RITMechArch/MechArch/pcbs/HBridge/design/HBridge.jpg

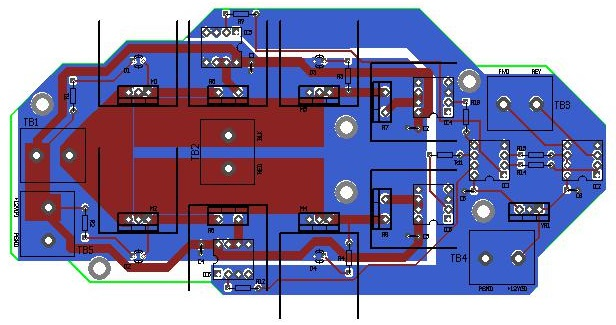
pcbs/HBridge/design/HBridge.jpg
