RITMechArch/MechArch/doc/States & Transitions.jpg

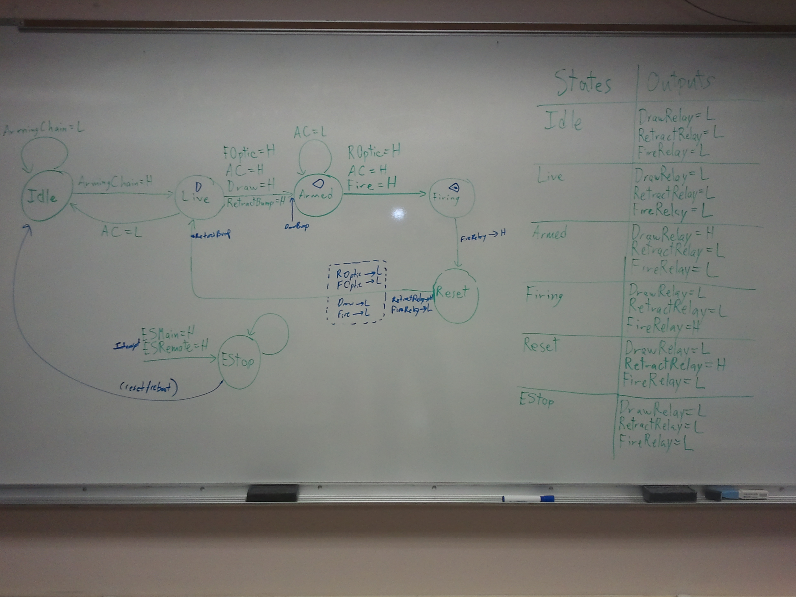
doc/States & Transitions.jpg
