RITMechArch/MechArch/README.md

MechArcher
==========

Mechanical Archer project from the Archery Club at RIT.
