RITMechArch/MechArch/pcbs/HBridge/design/gerber/readme

Reserved for Gerber (RS-274X) PCB files.
