RITMechArch/MechArch/pcbs/Boost Converter/Design/Boost Converter (PCB - PLOT REPORT).txt

PLOT REPORT
-----------

Report File    : C:\Users\Alex\Documents\GitHub\MechArch\pcbs\Boost Converter\Design\Boost Converter (PCB - PLOT REPORT).txt
Report Written : Sunday, February 23, 2014
Design Path    : C:\Users\Alex\Documents\GitHub\MechArch\pcbs\Boost Converter\Design\Boost Converter.pcb
Design Title   : 
Created        : 2/16/2014 10:12:48 AM
Last Saved     : 2/23/2014 3:22:08 PM
Editing Time   : 266 min
Units          : thou (precision 0)

Device Settings
===============

Gerber Settings
===============

    Leading zero suppression.
    G01 assumed throughout.
    Line termination <*> <CR> <LF>.
    2.3 format absolute inches.

    Format commands defined in Gerber file.
    Aperture table defined in Gerber file.
    Hardware arcs allowed.

Drill Settings
==============

    Excellon Format 1    Format 2.3 absolute in mm.
    No zero suppression.

Plots Output
============

    Plot Job: "C:\Users\Alex\Documents\GitHub\MechArch\pcbs\Boost Converter\Design\Boost Converter.mop"

Gerber Output
=============

C:\Users\Alex\Documents\GitHub\MechArch\pcbs\Boost Converter\Design\Boost Converter - Top Silkscreen.gbr

    Layers:
    ----------------
    Top Silkscreen

    D-Code  Shape  (thou)
    ---------------------
    D10     Round 5.00
    D27     Round 7.00

Gerber Output
=============

C:\Users\Alex\Documents\GitHub\MechArch\pcbs\Boost Converter\Design\Boost Converter - Top Copper.gbr

    Layers:
    ------------
    Top Copper

    D-Code  Shape  (thou)
    ---------------------
    D11     Round 150.00
    D12     Round 80.00
    D13     Round 70.00
    D14     Round 60.00
    D15     Round 110.00
    D16     Round 75.00
    D17     Round 15.00
    D18     Round 100.00
    D22     Round 70.00
    D23     Round 90.00

Gerber Output
=============

C:\Users\Alex\Documents\GitHub\MechArch\pcbs\Boost Converter\Design\Boost Converter - Top Copper (Resist).gbr

    Layers:
    ------------
    Top Copper

    D-Code  Shape  (thou)
    ---------------------
    D19     Round 160.00
    D70     Round 90.00
    D71     Round 80.00
    D20     Round 70.00
    D24     Round 120.00
    D25     Round 80.00
    D26     Round 100.00

Gerber Output
=============

C:\Users\Alex\Documents\GitHub\MechArch\pcbs\Boost Converter\Design\Boost Converter - Bottom Copper.gbr

    Layers:
    ---------------
    Bottom Copper

    D-Code  Shape  (thou)
    ---------------------
    D11     Round 150.00
    D12     Round 80.00
    D13     Round 70.00
    D14     Round 60.00
    D15     Round 110.00
    D17     Round 15.00
    D22     Round 70.00
    D23     Round 90.00

Gerber Output
=============

C:\Users\Alex\Documents\GitHub\MechArch\pcbs\Boost Converter\Design\Boost Converter - Bottom Copper (Resist).gbr

    Layers:
    ---------------
    Bottom Copper

    D-Code  Shape  (thou)
    ---------------------
    D19     Round 160.00
    D70     Round 90.00
    D71     Round 80.00
    D20     Round 70.00
    D24     Round 120.00
    D25     Round 80.00
    D26     Round 100.00

NC Drill Output
===============

C:\Users\Alex\Documents\GitHub\MechArch\pcbs\Boost Converter\Design\Boost Converter - Drill Data - Through Hole.drl

    Output:
    --------------------------
    Plated Round Drill Holes
    Plated Slots
    Plated Board Outlines

    Tool   Size       Count    ID
    -----------------------------
    T001   00.030 in  2      K
    T002   00.032 in  12     G
    T003   00.034 in  2      J
    T004   00.040 in  16     D
    T005   00.042 in  5      F
    T006   00.050 in  3      L
    T007   00.057 in  4      H
    T008   00.074 in  2      I
    T009   00.120 in  6      M
    -----------------------------
    Total             52
    -----------------------------
    Tool   Size       Count    ID
    -----------------------------
    T001   00.025 in  1
    -----------------------------
    Total             1
    -----------------------------

Gerber Output
=============

C:\Users\Alex\Documents\GitHub\MechArch\pcbs\Boost Converter\Design\Boost Converter - Drill Ident Drawing - Through Hole.gbr

    Layers:
    ----------------
    [Through Hole]

Drill Ident Drawing
===================

    Drill  Plated  Size  Shape  ID
    ------------------------------
    40     Y       100   Round  D
    42     Y       100   Round  F
    32     Y       100   Round  G
    57     Y       100   Round  H
    74     Y       100   Round  I
    34     Y       100   Round  J
    30     Y       100   Round  K
    50     Y       100   Round  L
    120    Y       100   Round  M

    D-Code  Shape  (thou)
    ---------------------
    D10     Round 5.00
    D18     Round 100.00

Gerber Output
=============

C:\Users\Alex\Documents\GitHub\MechArch\pcbs\Boost Converter\Design\Boost Converter - Board Outline.gbr

    Layers:
    ----------------
    Board Outlines

    D-Code  Shape  (thou)
    ---------------------
    D10     Round 5.00

End Of Report.
