RITMechArch/MechArch/doc/Mechanical Archer Requirements.docx

# Mechanical Archer

Requirements

1 Revision History

2 Background

3 Scope

3.1 In scope

3.2 Out of Scope

4 Functional Requirements

5 Non-Functional Requirements

6 Constraints

7 Assumptions

# 1 Revision History

Revision | Description | Date
0.1 | Created Document | 22APR2012

# 2 Background

The Mechanical Archer project is an effort to engineer and construct a device which will mechanically fire a bow and arrow at a designated target.

# 3 Scope

## 3.1 In scope

1. Control Box
  a. Box design
  b. Wiring
  c. Construction
2. Frame
  a. Design
  b. Construction
3. Firing mechanism
  a. Bow
  b. Drawing mechanism
  c. Release/trigger

## 3.2 Out of Scope

1. “Hands-off” reloading
2. Aiming (beyond pointing the frame itself)

# 4 Functional Requirements

1. System must mechanically fire bow
  a. Manually load arrow
  b. Mechanically pull bowstring to rear
  c. Mechanically release bowstring
  d. Mechanically return mechanism & re-attach to bowstring
2. System must be safely and remotely controlled
  a. Control box
  b. “Dead man’s” switch
  c. Locking/arming key
  d. Sensor to disable drawing/firing when unloaded
3. Riser Attachment System
  a. Cast dragon skin silicone “glove”
  b. Anti-torque structure

# 5 Non-Functional Requirements

1. Bow limb shall be safe and have useful life
  a. Mounting considerations
  b. Winch movement safeguards
2. Frame shall be reliable within tolerances
3. Frame shall be roughly aimable

# 6 Constraints

1. Project budget is $1000
2. Functional & tested by May 2013

# 7 Assumptions

1. Bow draw strength of 50 lbs
2. Available 120V AC outlet
