RITMechArch/MechArch/doc/Projects Slide.pptx

## Mech ArcherThis ain't your daddy's bow

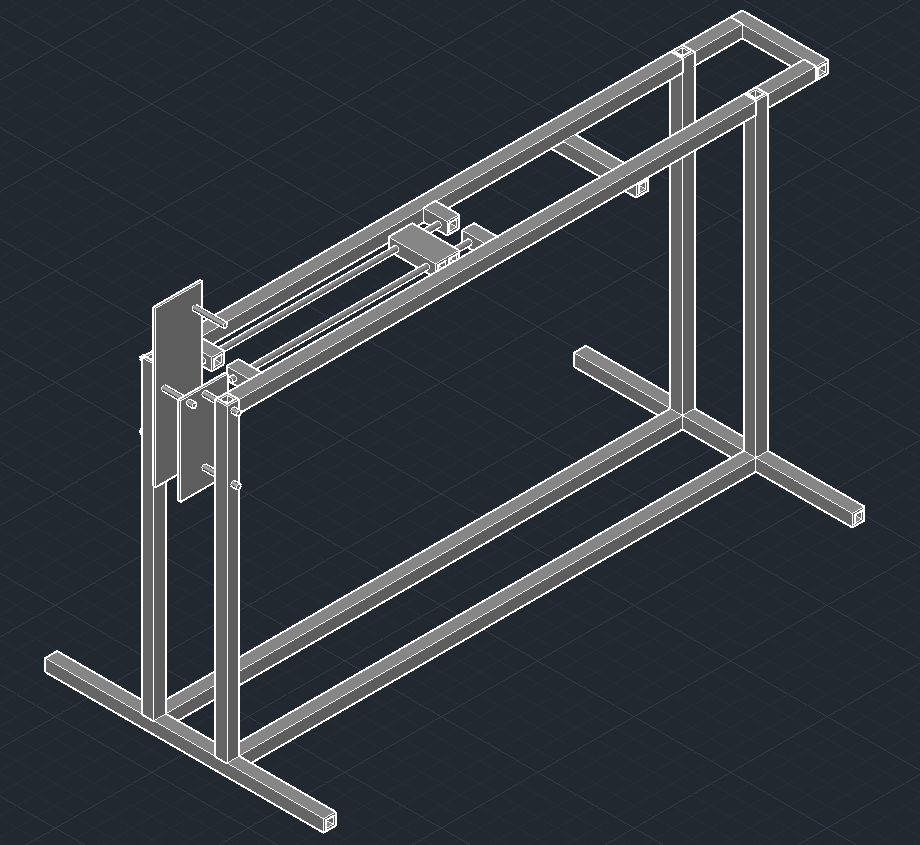
[picture p3: figure]

(insert another picture)
- Imagine RIT exhibit
- Arduino driven
Contact bmb8610@rit.edu for more info

Notes: Style left blank since you're adding this to another presentation
