RITMechArch/MechArch/mechanical/Gear_Motor_Mount_Holes.xlsx

Castor Mount Holes |  | Initial Wheel Holes |  | Rotate: | -14 | degrees | Rotation Result |  | Wheel Mount Holes
D = 3/16" |  |  |  |  | -0.2443460953 | radians |  |  | D = 0.14"
X (in) | Y (in) | X (in) | Y (in) | X (in) | Y (in) |  | X (in) | Y (in) | X (in) | Y (in)
0.5 | 0.5 | 0 | 0 | 0.9702957263 | 0.2419218956 |  | 0 | 0 | 1 | 1.75
2.875 | 0.5 | 1.061 | 0 | -0.2419218956 | 0.9702957263 |  | 1.029 | -0.257 | 2.029483766 | 1.493320869
0.5 | 4.125 | 0 | 1.5 |  |  |  | 0.363 | 1.455 | 1.362882843 | 3.205443589
2.875 | 4.125 | 1.061 | 1.5 |  |  |  | 1.392 | 1.199 | 2.392366609 | 2.948764458
Initial Motor Holes |  |  |  |  |  |  |  |  | Motor Mount Holes
 |  |  |  |  |  |  |  |  | D = 0.14"
X (in) | Y (in) | X (in) | Y (in) |  |  |  |  |  | X (in) | Y (in)
-1.0945 | 0 | -1.0945 | 4 |  |  |  | -0.09430109001 | 4.14596642 | 0.90569891 | 5.89596642
2.1555 | 0 | 2.1555 | 4 |  |  |  | 3.059 | 3.360 | 4.05916002 | 5.109720259
-1.0945 | 2.125 | -1.0945 | 6.125 |  |  |  | 0.420 | 6.208 | 1.419782938 | 7.957844838
2.1555 | 2.125 | 2.1555 | 6.125 |  |  |  | 3.573 | 5.422 | 4.573244049 | 7.171598677
On Mill Positions:
Castor Mount Holes |  | Wheel Mount Holes |  | Motor Mount Holes
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
