RITMechArch/MechArch/doc/Pinout-R2.xlsx

Sheet: Frameside
Signal Name | Signal Type | In/Out | Pin # | PWM | Interrupt-Driven | Description
E-StopRemote | Digital | Input | 18 | No | Yes(5) | Emergency Stop button on frame
E-StopMain | Digital | Input | 19 | No | Yes(4) | Emergency Stop button on control box
FOptic | Digital | Input | 30 | No | No | Front optical sensor (low: arrow present; high: arrow absent)
ROptic | Digital | Input | 32 | No | No | Rear optical sensor (low: arrow present; high: arrow absent)
Drawing Linac Feedback Pin | Analog | Input | A2 | No | No | Feedback pin for the drawing linear actuator.
Drawing Linac Motor Enable | Digital | Output | 3 | Yes | No | Enable for the drawing linear actuator.
Drawing Linac Motor Direction | Digital | Output | 5 | No | No | Direction for the drawing linear actuator.
Aiming Linac Feedback Pin | Analog | Input | A5 | No | No | Feedback pin for the aiming linear actuator.
Aiming Linac Motor Enable | Digital | Output | 6 | Yes | No | Enable for the aiming linear actuator.
Aiming Linac Motor Direction | Digital | Output | 8 | No | No | Direction for the aiming linear actuator.
Aiming Gear Motor Enable | Digital | Output | 9 | Yes | No | Enable for the aiming gear motor.
Aiming Gear Motor Direction | Digital | Output | 12 | No | No | Direction for the aiming gear motor.
Rotary Encoder PinA | Digital | Input | 21 | No | Yes(3) | Interrupt Pin A on the rotary encoder.
Rotary Encoder PinB | Digital | Input | 20 | No | Yes(2) | Interrupt Pin B on the rotary encoder.
High Power Solenoid | Digital | Output | 38 | No | No | High power fire solenoid used for firing.
Low Power Solenoid | Digital | Output | 40 | No | No | Low power fire solenoid used to grab the string.
Ethernet Shield SD Select | Digital | Output | 4 | No | No | SD Card Select on the Ethernet shield; this must be disabled.
Ethernet Shield W5100 Select | Digital | Output | 10 | No | No | Wired Ethernet select on the Ethernet shield.
Ethernet Shield SPI Output | Digital | Output | 53 | No | No | Required output for the Ethernet shield, per Arduino Ethernet Shield main page.

Sheet: Control Box
Signal Name | Signal Type | In/Out | Pin # | PWM | Interrupt-Driven | Description
RX0 | Digital | Input | 0 | No | No | Receiving line for serial communications
TX0 | Digital | Output | 1 | No | No | Transmitting line for serial communications
E-StopRemote | Digital | Input | 18 | No | Yes(5) | Emergency stop button on the frame
E-StopMain | Digital | Input | 19 | No | Yes(4) | Emergency stop button on the control box
LEDClock | Digital | Output | 30 | No | No | Time until next fire information
LEDData | Digital | Output | 32 | No | No | Data output for LED shift registers.
LCDRegSelect | Digital | Output | 37 | No | No | Register Select for LCD display on control box
LCDEnable | Digital | Output | 39 | No | No | Enable for LCD display on control box
Arming Chain | Digital | Input | 40 | No | No | Combination of key, switch, and deadman button on the control box.
DrawInput | Digital | Input | 42 | No | No | Draw button on the control box
RetractInput | Digital | Input | 44 | No | No | Retract button on the control box
FireInput | Digital | Input | 46 | No | No | Fire button on the control box
LCD Data, D4/D5/D6/D7 | Digital | Output | 41/43/45/47 | No | No | Data pins for LCD display on control box.
