RITMechArch/MechArch/pcbs/HBridge/ATTiny13A_Pinout.xls

ATTiny13A Pinout
Physical Pin | Pin Label | Description
1 | PB5 | PMOS M1
2 | PB3 | Forward signal
3 | PB4 | Reverse signal
4 | GND | Ground
5 | PB0 | NMOS M3 (PWM)
6 | PB1 | NMOS M4 (PWM)
7 | PB2 | PMOS M2
8 | VCC | 5V rail
