RITMechArch/MechArch/doc/State Diagram - R2.jpg

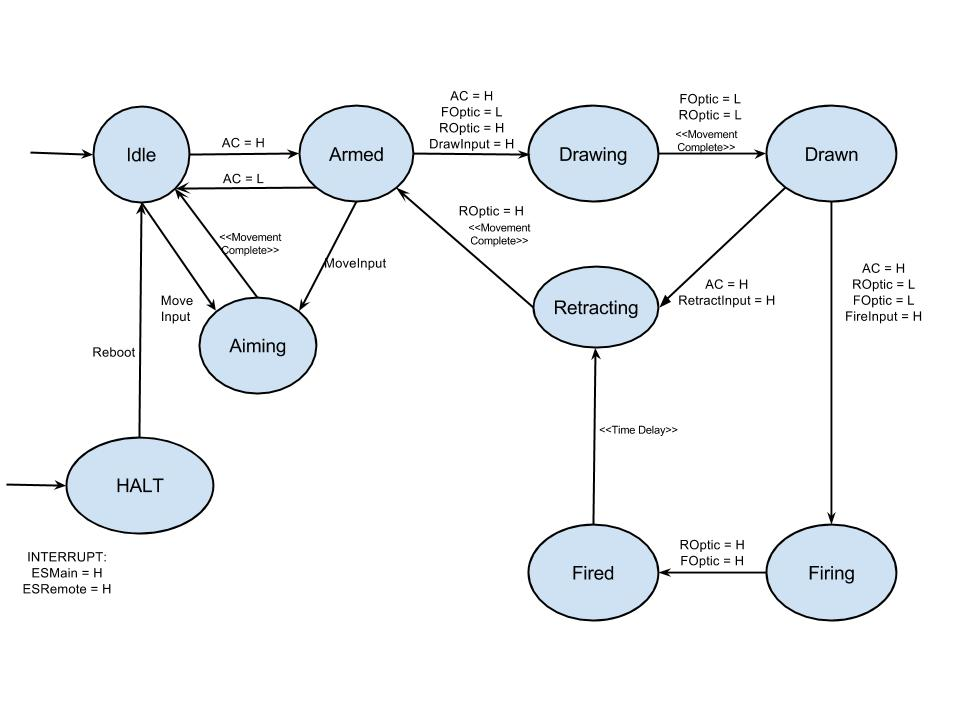
doc/State Diagram - R2.jpg
