RITMechArch/MechArch/mechanical/Design Spark Parts/Mechanical Archer Frame.png

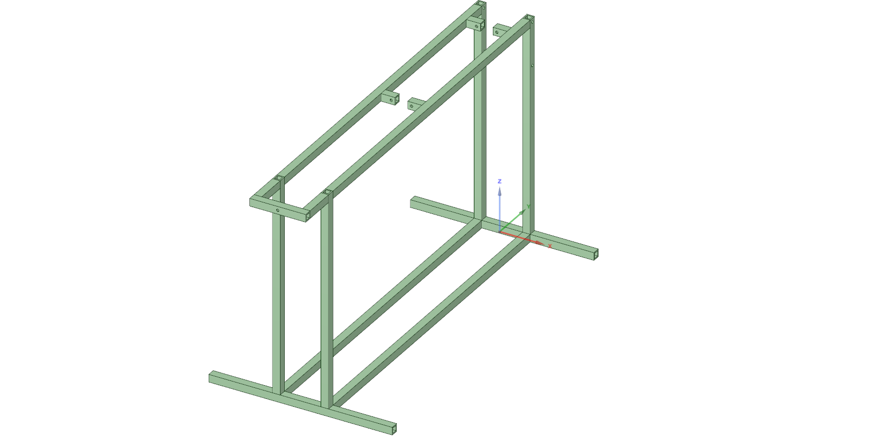
mechanical/Design Spark Parts/Mechanical Archer Frame.png
