RITMechArch/MechArch/pcbs/Boost Converter/Design/Boost Converter PCB.png

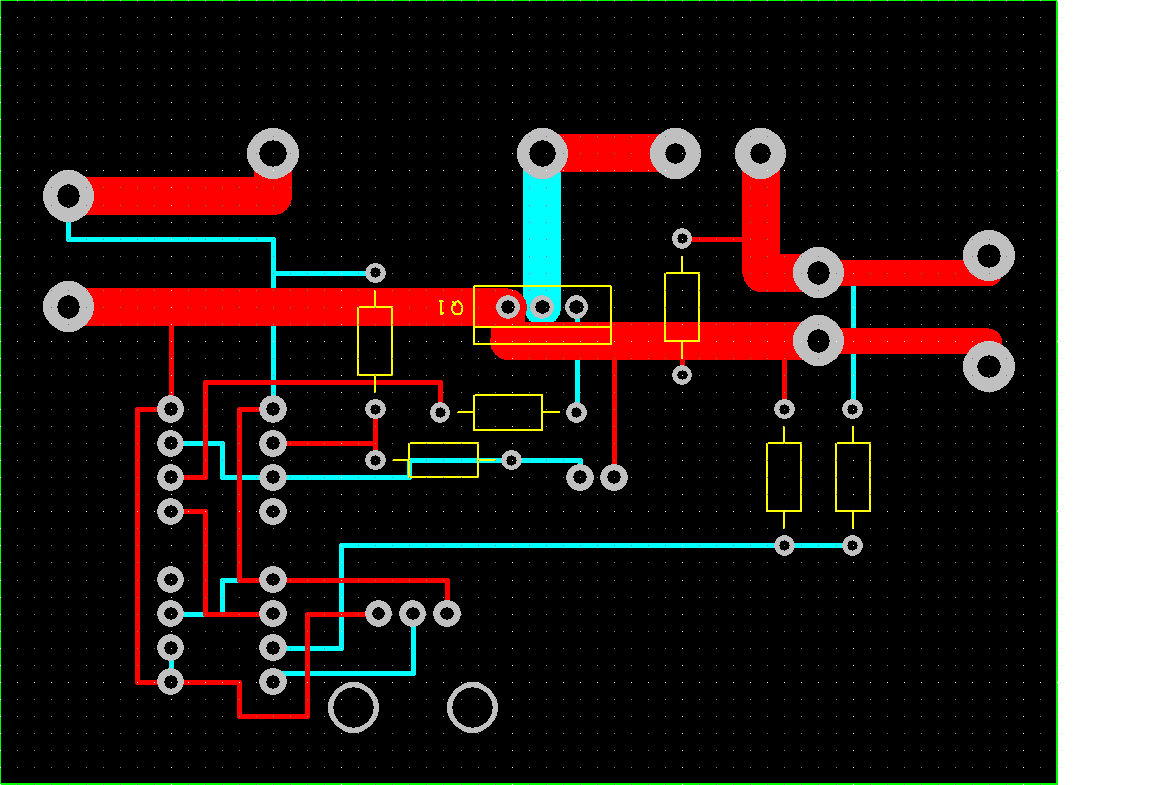
pcbs/Boost Converter/Design/Boost Converter PCB.png
