RITMechArch/MechArch/pcbs/Boost Converter/Design/Boost Converter.png

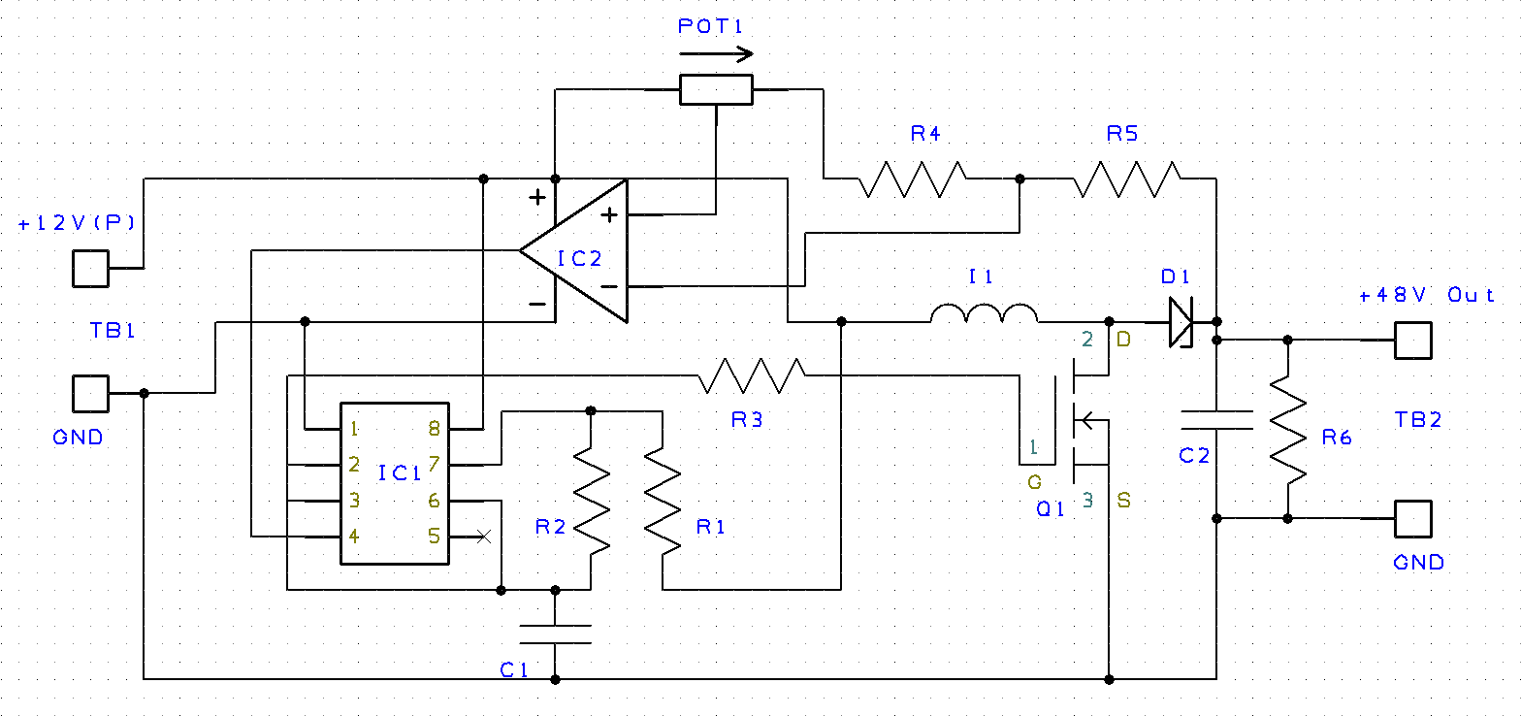
pcbs/Boost Converter/Design/Boost Converter.png
