RITMechArch/MechArch/pcbs/solenoid/design/solenoid.jpeg

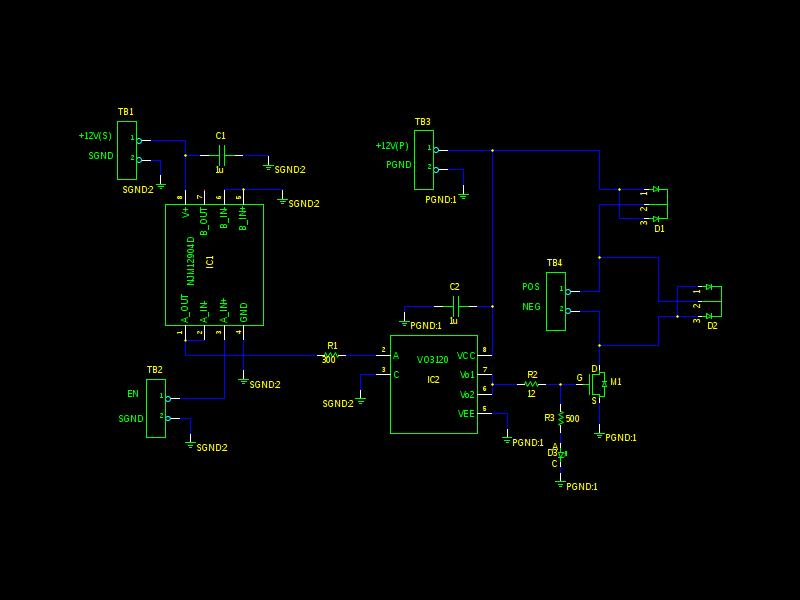
pcbs/solenoid/design/solenoid.jpeg
