RITMechArch/MechArch/pcbs/solenoid/design/solenoid.jpg

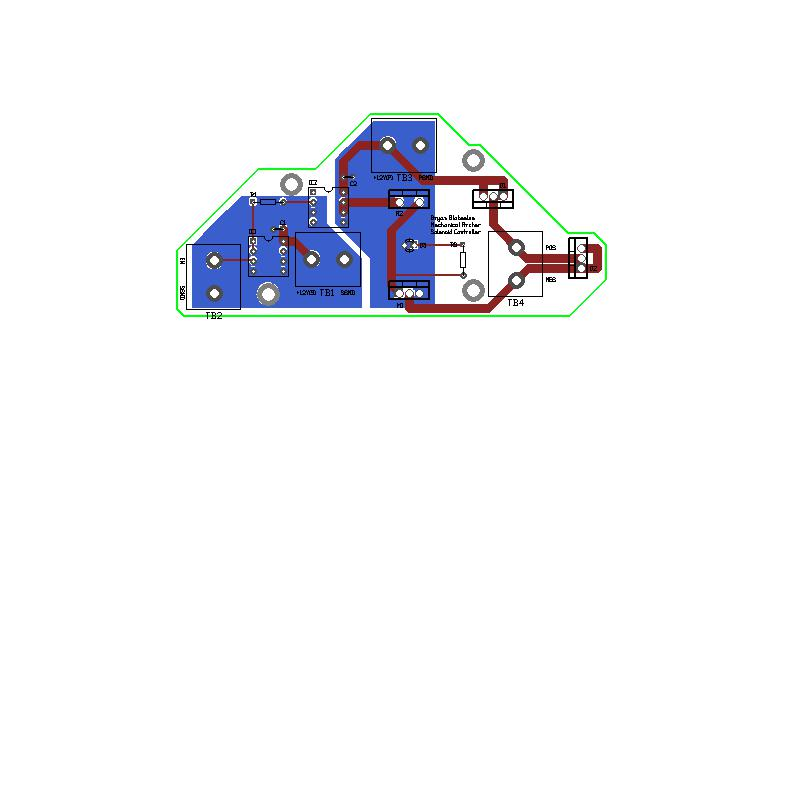
pcbs/solenoid/design/solenoid.jpg
