RITMechArch/MechArch/doc/Control_BOM.xlsx

Part # | Distributor | Description | Quantity | Unit Price | Total Price
V2018-ND | DigiKey | Solder proto board, common bus strips | 1 | 5.75 | 5.75
94669A097 | McMaster | Mounting spacer, M3, 4mm length | 12 | 0.29 | 3.48
96741A122 | McMaster | Machine screw, M3, 12mm length, 50 pk. | 1 | 7.11 | 7.11
94150A325 | McMaster | Nut for machine screw, M3, 50 pk. | 1 | 3.08 | 3.08
93925A240 | McMaster | Locking washers, M3, 100 pk. | 1 | 2.26 | 2.26
CKM12BTW01 | Mouser | Key switch | 1 | 11.66 | 11.66
M2012SS1G01-RO | Mouser | Master arm toggle switch | 1 | 4.76 | 4.76
MB2011SD3G01-CA | Mouser | Pushbutton switch, Draw, Black | 4 | 5.85 | 23.40
AT407F | Mouser | Cap, pushbutton switch, Retract, Green | 1 | 1.13 | 1.13
AT407C | Mouser | Cap, pushbutton switch, Fire, Red | 1 | 0.59 | 0.59
AT407B | Mouser | Cap, pushbutton switch, Deadman, White | 1 | 0.53 | 0.53
KB16CKG01-CC | Mouser | E-Stop button | 2 | 9.15 | 18.30
P160KNP-0QD20B10K | Mouser | Brightness trimmer pot for screen | 1 | 0.88 | 0.88
JBH-4957-KO | Mouser | Metal electronics enclosure | 1 | 20.50 | 20.50
RN60D2501FB14 | Mouser | Current limiting resistor, 2.5k | 8 | 0.20 | 1.60
SRCN2A25-16S | Mouser | Panel mount connector, female, 16 pin | 2 | 6.71 | 13.42
SRCN6A25-16P | Mouser | Cable connector, male, 16 pin | 2 | 11.59 | 23.18
163-MJ22-EX | Mouser | Panel mount DC barrel jack | 1 | 2.77 | 2.77
412-212103 | Mouser | Wall wart, 12VDC, barrel plug | 2 | 12.19 | 24.38
MC7805CTG | Mouser | Linear regulator, 5VDC, 1A | 2 | 0.40 | 0.80
FDH33_Q | Mouser | Diode for LCD screen backlight | 1 | 0.03 | 0.03
LCD-00256 | SparkFun | Monochrome 4x20 screen | 1 | 17.95 | 17.95
PRT-00116 | SparkFun | Header strip, 40 pin, vertical | 1 | 1.50 | 1.50
PRT-09140 | SparkFun | Jumper wires, M/F, 6", 10 pk. | 2 | 3.95 | 7.90
PRT-09385 | SparkFun | Jumper wires, M/F, 12", 10 pk. | 1 | 4.50 | 4.50
COM-10002 | SparkFun | Potentiometer knob | 1 | 1.50 | 1.50
 |  |  |  | Total Cost | 202.96
