RITMechArch/MechArch/pcbs/Boost Converter/Boost Converter BOM.xlsx

Part Number | Description | Price | Quantity | Cost | Reference Designator
512-LM555CN | 555 Timer IC for boost converter PWM | $0.44 | 1 | $0.44 | IC1
581-SR151A101JAR | Timing Capacitor for 555 Timer, 100 pF | $0.23 | 1 | $0.23 | C1
71-RN65C8002B | R1 timing resistor for 555 Timer, 80 KOhm | $1.06 | 1 | $1.06 | R1
71-PTF5640K000BYEB | R2 timing resistor for 555 Timer, 40 KOhm | $0.61 | 1 | $0.61 | R2
71-CMF6080R000BHEB | Output current limiting resistor for 555 Timer, 80 Ohm | $0.46 | 1 | $0.46 | R3
542-1130-220K-RC | Inductor for Boost Convertor, 22 uH | $4.64 | 1 | $4.64 | I1
863-MBR1060G | Boost Converter flyback diode | $0.99 | 1 | $0.99 | D1
844-IRFIZ14GPB | Boost Converter switching transistor, N-MOS | $1.65 | 1 | $1.65 | Q1
647-UVY2G100MPD | Boost Converter output leveling capacitor, 10 uF | $0.62 | 1 | $0.62 | C2
594-VR37000001004FR5 | Feedback voltage divider low side resistor, 1 MOhm | $0.19 | 1 | $0.19 | R4
71-CMF5519M100GNBF | Feedback voltage divider high side resistor, 19.1 MOhm | $0.52 | 1 | $0.52 | R5
595-RC4558P | Feedback op-amp for controlling RESET on 555 | $0.43 | 1 | $0.43 | IC2
688-RK09K1130AP5 | Feedback reference voltage potentiometer, 10 KOhm | $0.49 | 1 | $0.49 | POT1
791-RC1/2-203JB | Bleeder resitor for leveling capacitor, 20 KOhm | $0.36 | 1 | $0.36 | R6
571-1977477-2 | Terminal blocks for input and output | $1.45 | 2 | $2.90 | TB1, TB2
517-4808-3000-CP | Socket for 8-pin ICs | $0.28 | 2 | $0.56
 |  |  | Board: | $33.00
 |  |  | Parts: | $16.15
 |  |  | Total: | $49.15
