RITMechArch/MechArch/Things to buy as of 2-19-2014.xlsx

Mouser.com Part Number | Description | Price | Quantity | Cost | Reference Designator
828-OP906 | IR laser detector photodiode | $0.55 | 2 | $1.10 | PD1
MFS1/4DCT52R2003F | Photodiode current limiter, 200 kOhms | $0.06 | 2 | $0.12 | R1
T73YU103KT20 | Reference potentiometer, 10 kOhms | $0.71 | 2 | $1.42 | R2
513-NJM12904D | Op-amp comparator | $0.49 | 2 | $0.98 | U1
571-1977477-2 | Terminal block, 2 position | $1.37 | 8 | $10.96 | TB1, TB2
859-LTL-1CHAE | Activity indicator LED | $0.08 | 2 | $0.16 | D2
660-MF1/4DCT52R2000F | LED current limiter, 200 Ohms | $0.06 | 4 | $0.24 | R3
810-FK14X7R1H105K | Bypass cap for op-amps, 1 uF | $0.40 | 2 | $0.80 | C1
828-OPV310 | Laser diode | $11.45 | 2 | $22.90 | D1
660-MF1/4DC1501F | Current limiting resistor, 1.5k Ohms | $0.06 | 2 | $0.12 | R1
CMF55500R00FEBF | Current limiting resistor, 500 Ohms | $0.25 | 2 | $0.50 | R2
859-LTL-1CHAE | Activity indicator LED | $0.08 | 2 | $0.16 | D2
512-LM555CN | 555 Timer IC for boost converter PWM | $0.44 | 1 | $0.44 | IC1
581-SR151A101JAR | Timing Capacitor for 555 Timer, 100 pF | $0.23 | 1 | $0.23 | C1
71-RN65C8002B | R1 timing resistor for 555 Timer, 80 KOhm | $1.06 | 1 | $1.06 | R1
71-PTF5640K000BYEB | R2 timing resistor for 555 Timer, 40 KOhm | $0.61 | 1 | $0.61 | R2
71-RS00280R00FE70 | Output current limiting resistor for 555 Timer, 80 Ohm | $0.46 | 1 | $0.46 | R3
542-1130-220K-RC | Inductor for Boost Convertor, 22 uH | $4.64 | 1 | $4.64 | I1
863-MBR1060G | Boost Converter flyback diode | $0.99 | 1 | $0.99 | D1
511-STP16NF06 | Boost Converter switching transistor, N-MOS | $0.88 | 1 | $0.88 | Q1
647-UVY2G100MPD | Boost Converter output leveling capacitor, 10 uF | $0.62 | 1 | $0.62 | C2
660-MF1/4DCT52R9532F | Feedback voltage divider high side resistor, 95.3 kOhm | $0.06 | 1 | $0.06 | R4
71-CMF555K0000BHEB | Feedback voltage divider low side resistor, 5.0 kOhm | $0.59 | 1 | $0.59 | R5
594-VR37000001004FR5 | Output capacitor bleeder resistor, 1 Mohm | $0.19 | 1 | $0.19 | R6
595-RC4558P | Feedback op-amp for controlling RESET on 555 | $0.43 | 1 | $0.43 | IC2
688-RK09K1130AP5 | Feedback reference voltage potentiometer, 10 KOhm | $0.49 | 1 | $0.49 | POT1
517-4808-3000-CP | Socket for 8-pin ICs | $0.28 | 2 | $0.56
852-PC81100NSZ0F | Opto-isolator for H-Bridge interface | $0.28 | 2 | $0.56
602-3055-100-28 | 100 feet 18AWG | $37.03 | 1 | $37.03
602-3051-100-14 | 100 feet 22AWG | $21.92 | 1 | $21.92
Pololu.com Part Number | Description | Price | Quantity | Cost | Reference Designator
755 | H-Bridge power side | $39.95 | 1 | $39.95
1404 | Linear Actuator travel limit switches | $0.85 | 2 | $1.70
 |  |  | Parts Cost: | $152.87
