RITMechArch/MechArch/R_2.5/NetworkingFields.ods

Sheet: Arduino to Computer
Component | Possible Values | Size (Bytes) | Notes
E-Stop Status | 1 (Active), 0 (Inactive) | 1
X Position | -4000 to 4000 | 2 | Exact range yet to be determined, and may be converted to an unsigned value from 0-8000.
Y Position | 100 to 4000 | 2 | Exact range to be determined
Z Position | 100 to 4000 | 2 | Exact range to be determined; lower positions correspond to a drawn bow, higher positions correspond to a retracted bow.
Front Optic Sensor | 1 (Arrow absent), 0 (Arrow present) | 1
Rear Optic Sensor | 1 (Arrow absent), 0 (Arrow present) | 1
Firing Block Status | 1(Open), 0(Closed) | 1 | This value currently assumes the solenoid mechanism used in revision 2. The value may change to use a servo with a valid range of 0-180, still using 1 byte.
String Held | 1(True), 0(False) | 1
Current Sensor 1 | 0-5000? | 2 | Need to verify range
Current Sensor 2 | 0-5000? | 2 | Need to verify range
Current Sensor 3 | 0-5000? | 2 | Need to verify range
Current Sensor 4 | 0-5000? | 2 | Need to verify range

Sheet: Computer to Arduino
Component | Possible Values | Size (Bytes) | Notes
E-Stop Status | 1 (Active), 0 (Inactive) | 1
Draw Input | 1 (Active), 0 (Inactive) | 1 | Mutually exclusive with Retract Input and Fire Input
Retract Input | 1 (Active), 0 (Inactive) | 1 | Mutually exclusive with Draw Input and Fire Input
Fire Input | 1 (Active), 0 (Inactive) | 1 | Mutually exclusive with Draw Input and Retract Input
X Target Position | -4000 to 4000 | 2 | Exact range yet to be determined, and may be converted to an unsigned value from 0-8000.
Y Target Position | 100 to 4000 | 2 | Exact range to be determined
