RITMechArch/MechArch/doc/EEPROM Byte Listing.xlsx

Name | Starting Byte Number | Size (bytes) | Description
GM_MinPower | 0 | 1 | Minimum power for the horizontal aiming gear motor
GM_MaxPower | 4 | 1 | Maximum power for the horizontal aiming gear motor
GM_MinPosition | 8 | 2 | Minimum position the gear motor can move to.
GM_MaxPosition | 12 | 2 | Maximum position the gear motor can move to.
GM_FineControlDist | 16 | 2 | Distance from the current position at which proportional control will be used to slow the gear motor's movement for increased precision.
GM_Overshoot | 20 | 2
GM_MinMovement | 24 | 2 | Minimum position difference needed to trigger a move by the gear motor.
GM_ProportionalConst | 28 | 2 | Constant to be used in proportional controller for movement.
GM_IntegralConst | 32 | 2 | Constant to be used in integral controller for movement.
AL_MinPower | 36 | 1 | Minimum power for the aiming linear actuator.
AL_MaxPower | 40 | 1 | Maximum power for the aiming linear actuator.
AL_ZeroPosition | 44 | 2 | Center position for the aiming linear actuator.
AL_MinPosition | 48 | 2 | Minimum position the aiming linear actuator can move to.
AL_MaxPosition | 52 | 2 | Maximum position the aiming linear actuator can move to.
AL_FineControlDist | 56 | 2 | Distance from the current position at which proportional control will be used to slow the aiming linear actuator movement for increased precision.
AL_Overshoot | 60 | 2
AL_MinMovement | 64 | 2 | Minimum position difference needed to trigger a move by the aiming linear actuator.
AL_ProportionalConst | 68 | 2 | Constant to be used in proportional controller for movement.
AL_IntegralConst | 72 | 2 | Constant to be used in integral controller for movement.
DL_MinPower | 76 | 1 | Minimum power for the drawing linear actuator
DL_MaxPower | 80 | 1 | Maximum power for the drawing linear actuator
DL_MinPosition | 84 | 2 | Minimum position the drawing linear actuator can move to.
DL_MaxPosition | 88 | 2 | Maximum position the drawing linear actator can move to.
DL_IdlePosition | 92 | 2 | Position of the drawing linear actuator when the bow is retracted in an idle state.
DL_StringPosition | 96 | 2 | Position of the drawing linear actuator when grabbing the bow string.
DL_DrawnPosition | 100 | 2 | Position of the drawing linear actuator when the bow is considered drawn.
DL_FineControlDist | 104 | 2 | Distance from the current position at which proportional control will be used to slow the drawing linear actuator's movement for increased precision.
DL_Overshoot | 108 | 2
DL_MinMovement | 112 | 2 | Minimum position difference needed to trigger a move by the drawing linear actuator.
DL_ProportionalConst | 116 | 2 | Constant to be used in proportional controller for movement.
DL_IntegralConst | 120 | 2 | Constant to be used in integral controller for movement.
