RITMechArch/MechArch/doc/Mech Arch R2 Buy List.xlsx

Part # | Description | Price (USD) | Quantity | Total | Source
SDA18-263 | Linear Actuator for Vertical Positioning | $399.99 | 1 | $399.99 | servocity.com
CEM-1210-1M | Gear Motors for Horizontal Positioning | $59.99 | 2 | $119.98 | servocity.com
HDM500 | Linear Actuator Mounting Bracket | $34.99 | 2 | $69.98 | servocity.com
535158 | Pillow Block Bearing for Gear Motors and front hinges | $6.99 | 8 | $55.92 | servocity.com
595410 | 4" diameter heavy duty wheels | $6.99 | 2 | $13.98 | servocity.com
545560 | 0.770" set screw hub | $4.99 | 2 | $9.98 | servocity.com
 |  |  |  | $0.00
AD7706BNZ-ND | 3 Channel 16 bit ADC | $10.76 | 2 | $21.52 | digikey.com
CTX403-ND | 4.9152 MHz crystal oscillator for ADC master clock | $0.36 | 2 | $0.72 | digikey.com
338-1051-ND | 20 pF capacitors for the crystal oscillators | $1.63 | 4 | $6.52 | digikey.com
S110HCT-ND | 110 Ohm resistors for current limiting on the display LEDs | $0.04 | 50 | $2.13 | digikey.com
IRL640A | N-Channel MOSFET; 200V; 18A; for controlling the solenoid | $1.52 | 2 | $3.04 | digikey.com
PS2501-4A-ND | 4 Channel optoisolator | $1.84 | 1 | $1.84 | digikey.com
S240HCT-ND | 240 ohm resistor for optoisosolator output | $0.11 | 5 | $0.55 | digikey.com
CF14JT10K0CT-ND | 10k resistor for optoisolator output | $0.10 | 10 | $1.00 | digikey.com
30QBK-ND | 30 ohm resistor for LED display | $0.04 | 35 | $1.54 | digikey.com
CF14JT20K0CT-ND | 20k pull down resistor for transistor | $0.10 | 5 | $0.50 | digikey.com
 |  |  |  | $0.00
B003ZHV3TW | 1/2” x 5” x 36” 6061 Aluminum bar for gear motor mounts | $55.56 | 2 | $111.12 | amazonsupply.com
 |  |  |  | $0.00
 |  |  |  | $0.00
 |  |  |  | $0.00
 |  |  |  | $0.00
 |  |  |  | $0.00
 |  |  |  | $0.00
 |  |  |  | $0.00
 |  |  | Total: | $820.31
