RITMechArch/MechArch/doc/MechArchBudget.xls

Budget: | SSE Money: | $500.00
 | Archery Money: | $300.00
 | Total Money: | $800.00
 | SSE Money Spent: | $89.99
 | Archery Money Spent: | $311.67
 | SSE Money Remaining: | $410.01
 | Archery Money Remaining: | -$11.67
 | Total Money Remaining: | $398.34
 | Anticipated Expenses: | $211.07
 | Anticipated Total Money Remaining: | $187.27
Archery Expenses |  |  | SSE Expenses |  | Anticipated Expenses
Name | Cost |  | Name | Cost | Name | Cost | Notes
H-Bridge Parts | $94.58 |  | New power supply | $89.99 | Solenoid Controller Parts | $17.12
H-Bridge PCB (Wrong) | $92.75 |  |  |  | Solenoid Controller PCB | $43.95
Archery Release | $30.00 |  |  |  | Misc Wire & Lugs | $100.00 | Estimate
Solenoid | $16.95 |  |  |  | Acrylic & Sheet Metal | $50.00 | Estimate
Sensor Parts | $37.44
Motor Controller | $39.95
