RITMechArch/MechArch/pcbs/IR_Tx/IR_Tx_BoM.xls

Part Number | Description | Price | Quantity | Cost | Reference Designator
828-OPV310 | Laser diode | $11.45 | 2 | $22.90 | D1
660-MF1/4DC1501F | Current limiting resistor, 1.5k Ohms | $0.06 | 2 | $0.12 | R1
571-1977477-2 | Terminal block, 2 position | $1.37 | 2 | $2.74 | TB1
CMF55500R00FEBF | Current limiting resistor, 500 Ohms | $0.25 | 2 | $0.50 | R2
859-LTL-1CHAE | Activity indicator LED | $0.08 | 2 | $0.16 | D2
 |  |  | Board Cost | $8.23
 |  |  | Parts Cost | $26.42
 |  |  | Total Cost | $34.65
