RITMechArch/MechArch/pcbs/HBridge/BoM.xls

Part Number | Description | Price | Quantity | Cost | Reference Designator
726-IPP80P03P4L-04 | High side H-Bridge PMOS transistor | $1.95 | 3 | $5.85 | M1, M2
511-STP16NF06 | Low side H-Bridge NMOS transistor | $0.88 | 3 | $2.64 | M3, M4
504222B00000G | TO-220 heat sinks | $0.56 | 8 | $4.48 | N/A
556-ATTINY13A-PU | Microcontroller for signal decoding | $0.95 | 3 | $2.85 | IC1
513-NJM12904D | Dual op-amp buffers for high impedance input | $0.49 | 3 | $1.47 | IC2
810-FK14X7R1H105K | Bypass capacitors for ICs, 1uF | $0.40 | 6 | $2.40 | C1, C2, C3, C4, C5, C6
595-UA7805CKCT | Linear regulator for powering ATTiny | $0.60 | 2 | $1.20 | VR1
517-4808-3000-CP | Socket for 8-pin ICs | $0.28 | 8 | $2.24 | N/A
571-1977477-2 | Barrier terminal, 2 position | $1.37 | 5 | $6.85 | TB1, TB2, TB3, TB4, TB5
859-LTL-1CHAE | LED activity indicators | $0.08 | 6 | $0.48 | D1, D2, D3, D4
CMF55500R00FEBF | LED resistors, 500 Ohm | $0.25 | 6 | $1.50 | R1, R2, R3, R4
652-PWR221T-30-12R0F | Gate drive limiting resistors, 12 Ohm, 30W | $2.63 | 6 | $15.78 | R5, R6, R7, R8
71-CMF55250R00FKBF | Current limiting resistors for 5V signal lines, 250 Ohm | $0.16 | 6 | $0.96 | R13, R14
660-MF1/4DCT52R3000F | Current limiting resistors for gate driver LEDs, 300 Ohm | $0.06 | 8 | $0.48 | R9, R10, R11, R12
782-VO3120 | Opto-isolator, level shifter, current buffer | $1.55 | 5 | $7.75 | IC3, IC4, IC5, IC6
 |  |  | Board Cost | $85.50 | For 3 copies of the board
 |  |  | Part Cost | $56.93
 |  |  | Total Cost | $142.43
