RITMechArch/MechArch/pcbs/bumpSwitch/bumpSwitch_BoM.xls

Part Number | Description | Price | Quantity | Cost | Reference Designator
653-SS-01GL2 | Limit switch for actuator travel | $3.20 | 2 | $6.40 | N/A
