RITMechArch/MechArch/pcbs/solenoid/Solenoid_BoM.xls

Part Number | Description | Price | Quantity | Cost | Reference Designator
511-STP16NF06 | Solenoid control FET | $0.88 | 1 | $0.88 | M1
504222B00000G | TO-220 heat sinks | $0.56 | 4 | $2.24 | N/A
513-NJM12904D | Dual op-amp buffers for high impedance input | $0.49 | 1 | $0.49 | IC1
810-FK14X7R1H105K | Bypass capacitors for ICs, 1uF | $0.40 | 2 | $0.80 | C1, C2
517-4808-3000-CP | Socket for 8-pin ICs | $0.28 | 2 | $0.56 | N/A
571-1977477-2 | Barrier terminal, 2 position | $1.37 | 4 | $5.48 | TB1, TB2, TB3, TB4
859-LTL-1CHAE | LED activity indicators | $0.08 | 1 | $0.08 | D3
CMF55500R00FEBF | LED resistors, 500 Ohm | $0.25 | 1 | $0.25 | R3
652-PWR221T-30-12R0F | Gate drive limiting resistors, 12 Ohm, 30W | $2.63 | 1 | $2.63 | R2
660-MF1/4DCT52R3000F | Current limiting resistors for gate driver LEDs, 300 Ohm | $0.06 | 1 | $0.06 | R1
782-VO3120 | Opto-isolator, level shifter, current buffer | $1.55 | 1 | $1.55 | IC2
755-RSX1001T3 | Protection diodes for solenoid inductor | $1.05 | 2 | $2.10 | D1, D2
 | Board Cost:
 | Part Cost: | $17.12
 | Total Cost: | $17.12
