RITMechArch/MechArch/mechanical/Design Spark Parts/Firing Block Back.png

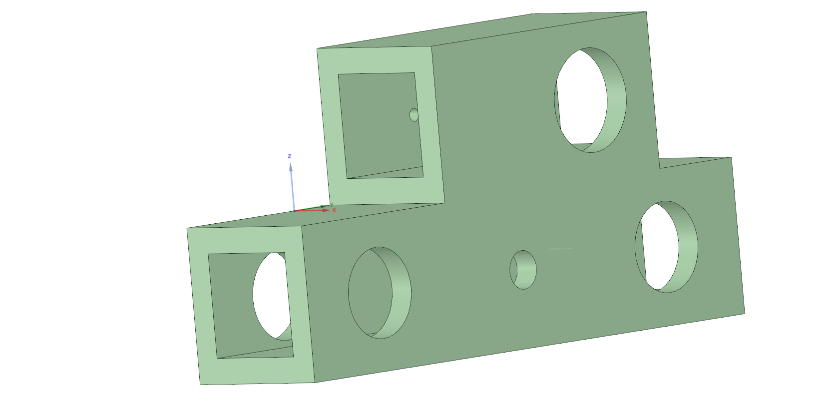
mechanical/Design Spark Parts/Firing Block Back.png
