RITMechArch/MechArch/mechanical/Design Spark Parts/Firing Block Front.png

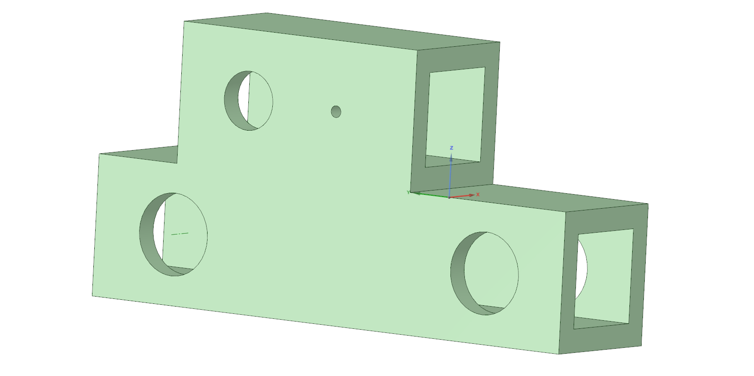
mechanical/Design Spark Parts/Firing Block Front.png
