RITMechArch/MechArch/mechanical/Design Spark Parts/Left Riser Mount.png

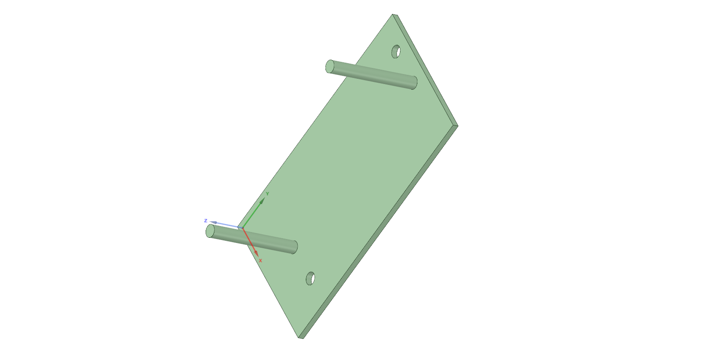
mechanical/Design Spark Parts/Left Riser Mount.png
