RITMechArch/MechArch/mechanical/Design Spark Parts/Right Riser Mount Left Side.png

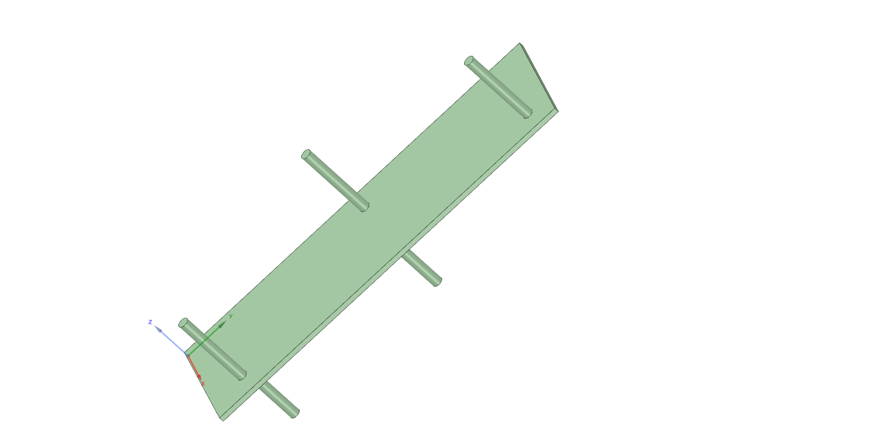
mechanical/Design Spark Parts/Right Riser Mount Left Side.png
