RITMechArch/MechArch/mechanical/Design Spark Parts/Right Riser Mount Right Side.png

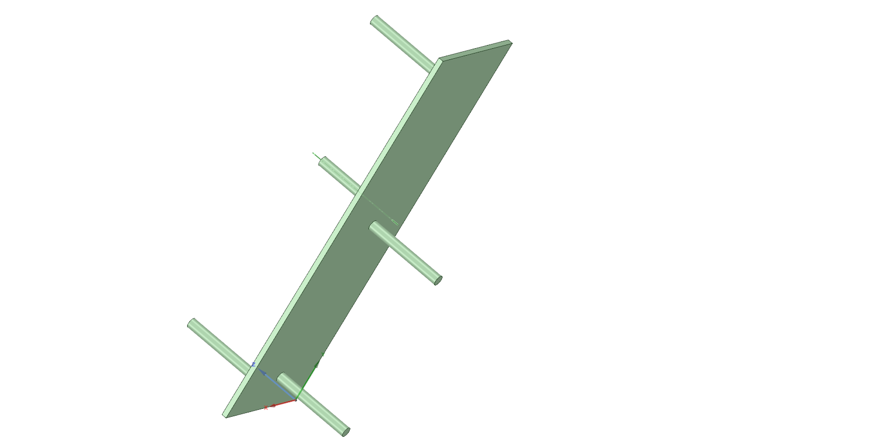
mechanical/Design Spark Parts/Right Riser Mount Right Side.png
