RITMechArch/MechArch/mechanical/Design Spark Parts/Fully Assembled Model.stl

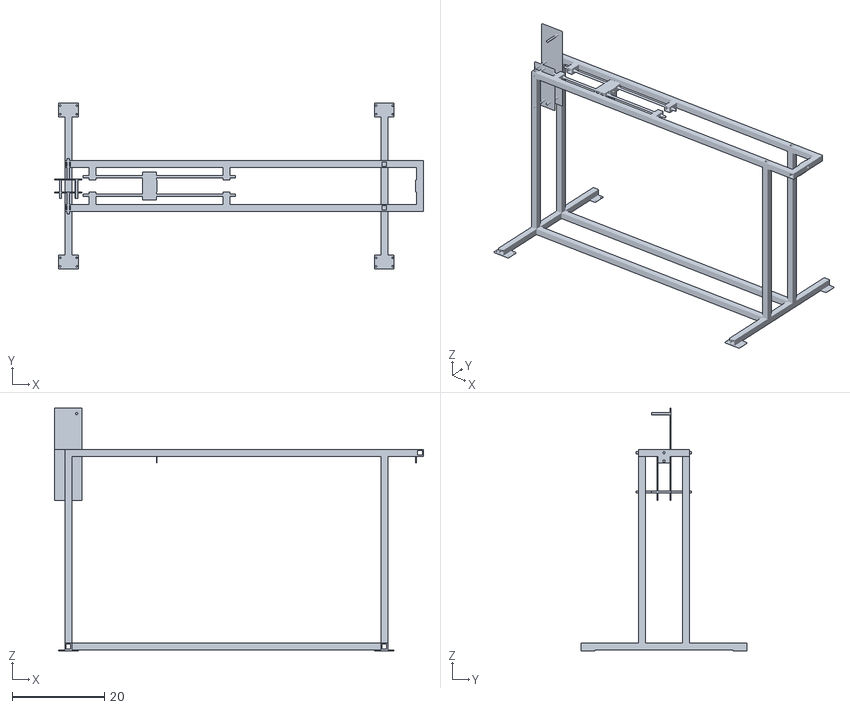
[picture p15: CAD file, 2013-10-20]
mechanical/Design Spark Parts/Fully Assembled Model.stl
80.0 x 36.0 x 52.6
