RITMechArch/MechArch/mechanical/Gear_Motor_Mount.stl

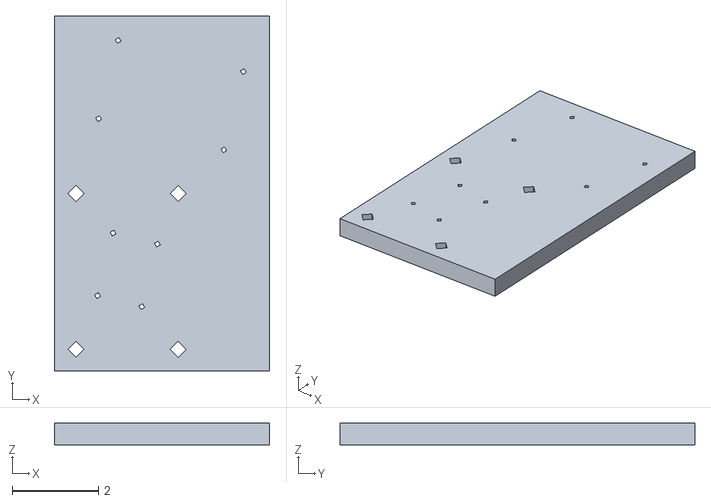
[picture p16: CAD file, 2015-07-14]
mechanical/Gear_Motor_Mount.stl
5.00 x 8.25 x 0.5
