RITMechArch/MechArch/(list of files, cad)

Other CAD files:
doc/Frame Design.dwg
mechanical/Gear_Motor_Mount.dxf
