RITMechArch/MechArch/(list of files, drawings)

Other design files:
pcbs/Boost Converter/Design/Boost Converter.pcb
pcbs/HBridge/design/HBridge.new.pcb
pcbs/HBridge/design/HBridge.pcb
pcbs/IR_Rx/design/IR_Rx.pcb
pcbs/IR_Tx/design/IR_Tx.new.pcb
pcbs/IR_Tx/design/IR_Tx.pcb
pcbs/solenoid/design/solenoid.new.pcb
pcbs/solenoid/design/solenoid.pcb
