RITMechArch/MechArch/src/arduino/Frameside/Frameside/Frameside.ino

#include <Ethernet.h>
#include <GearMotor.h>
#include <LinearActuator.h>
#include <SPI.h>

const int drawingLinacFeedback = 2;
const int drawingLinacEnable   = 3;
const int drawingLinacDir      = 5;

const int verticalFeedback     = 5;
const int verticalLinacEnable  = 6;
const int verticalLinacDir     = 8;

const int motorEnablePin  = 9;
const int motorDirPin     = 12;
const int pinA            = 21;
const int pinB            = 20;

const int fOptic          = 30;
const int rOptic          = 32;

const int fireSolenoid    = 38;

// ------- Ethernet Server Settings and Variables
byte mac[] = { 0xDE, 0xAD, 0xBE, 0xEF, 0xFE, 0xED };  
byte ip[] = { 169, 254, 211, 1 };    
byte gateway[] = { 129, 21, 249, 254 };
byte subnet[] = { 255, 255, 255, 0 };

EthernetServer server = EthernetServer(23);
EthernetClient tcpClient;
boolean hasConnected = false;
char buf[128];
int bufferSize = 0;
boolean hasArrow = false;

//-------- STATE const declarations -------------
const int STATE_IDLE        = 1;
const int STATE_ARMED       = 2;
const int STATE_AIMING      = 3;
const int STATE_DRAWING     = 4;
const int STATE_DRAWN       = 5;
const int STATE_RETRACTING  = 6;
const int STATE_FIRING      = 7;
const int STATE_FIRED       = 8;
const int STATE_HALT        = 9;
String stateNames[10] = {"STATE_IDLE", "STATE_ARMED", "STATE_AIMING", "STATE_DRAWING", "STATE_DRAWN", "STATE_RETRACTING", "STATE_FIRING", "STATE_FIRED", "STATE_HALT"};

int currentState = STATE_IDLE;

const int MOTOR_DISABLED = 0;

int startMovementTime = 0;
int fireDelay = -1;

LinearActuator drawingLinac = LinearActuator();
LinearActuator verticalLinac = LinearActuator();
GearMotor motor = GearMotor();

int drawingLinacPos = 0;
int verticalLinacPos = 0;
int motorPos = 0;

int motorTarget = 0;
int drawingLinacTarget = 400;
int verticalLinacTarget = 400;


// Serial booleans, set when valid commands are read from the Serial connection.

//boolean armingChainSerialIn = false;
boolean drawSerialIn        = false;
boolean retractSerialIn     = false;
boolean fireSerialIn        = false;

boolean movementRequested   = false;
boolean xMovementCompleted  = true;
boolean yMovementCompleted  = true;
boolean zMovementCompleted  = true;


const int yMinimum = 130;
const int zMinimum = 300;
const long zDrawnPosition     = 400;
const long zRetractedPosition = 3500;
const long zBowstringPosition = 3810;

void setup() {
    Serial.begin(9600);
    Serial1.end();
    Serial2.end();
    Serial3.end();
    
    // Mandatory ethernet pins
    // Disable DS card select.
    pinMode(4, OUTPUT);
    digitalWrite(4, HIGH);
    pinMode(10, OUTPUT);
    pinMode(53, OUTPUT);
    
    
    // Set up the pins for the motors
    pinMode(drawingLinacDir, OUTPUT);
    pinMode(drawingLinacEnable, OUTPUT);
    
    pinMode(verticalLinacDir, OUTPUT);
    pinMode(verticalLinacEnable, OUTPUT);
    
    pinMode(motorEnablePin, OUTPUT);
    pinMode(motorDirPin, OUTPUT);
    pinMode(pinA, INPUT);
    pinMode(pinB, INPUT);
  
    // Initialize all three of the motors.
    drawingLinac.init(drawingLinacDir, drawingLinacEnable, drawingLinacFeedback);
    verticalLinac.init(verticalLinacDir, verticalLinacEnable, verticalFeedback);
    motor.init(motorDirPin, motorEnablePin, pinA, pinB);
  
    // Take position samples and run them through the filter so our starting values are accurate
    for(int i = 0; i<100; i++)
    {
        drawingLinac.samplePosition();
        verticalLinac.samplePosition();
    }
  
    pinMode(fireSolenoid, OUTPUT);
    
    attachInterrupt(2, doPinA, CHANGE);
    attachInterrupt(3, doPinB, CHANGE);
    Ethernet.begin(mac, ip, gateway, subnet);
}

/* void initializeMotorPositions()
{
    verticalLinac.setMovementComplete(false);
    while (!verticalLinac.isMovementComplete())
    {
        verticalLinac.moveTo(1000);
    }
    drawingLinac.setMovementComplete(false);
    while(!drawingLinac.isMovementComplete())
    {
        drawingLinac.moveTo(zRetractedPosition);
    }
    motor.setMovementComplete(false);
    while(!motor.isMovementComplete())
    {
        motor.moveTo(-200);
    }
    motor.setMovementComplete(false);
    while(!motor.isMovementComplete())
    {
        motor.moveTo(200);
    }
} */

void loop() { 
    motorPos = motor.getPosition();
    verticalLinacPos = verticalLinac.getPosition();
    drawingLinacPos = drawingLinac.getPosition();
    checkEthernetInput();
  
    switch(currentState)
    {
        case STATE_HALT:
            set_halt_outputs();
            test_halt_transitions();
            return;
        case STATE_IDLE:
            set_idle_outputs();
            test_idle_transitions();
            break;
        case STATE_ARMED:
            set_armed_outputs();
            test_armed_transitions();
            break;
        case STATE_AIMING:
            // check_movement_time();
            set_aiming_outputs();
            test_aiming_transitions();
            break;
        case STATE_DRAWING:
            // check_movement_time();
            set_drawing_outputs();
            test_drawing_transitions();
            break;
        case STATE_DRAWN:
            set_drawn_outputs();
            test_drawn_transitions();
            break;
        case STATE_RETRACTING:
            // check_movement_time();        
            set_retracting_outputs();
            test_retracting_transitions();
            break;
        case STATE_FIRING:
            set_firing_outputs();
            test_firing_transitions();
            break;
        case STATE_FIRED:
            set_fired_outputs();
            test_fired_transitions();
            break;
        default:
            break;
    }
}

void doPinA()
{
    motor.doPinA();
}

void doPinB()
{
    motor.doPinB();
}


//=========================================
//=========================================
// State Outputs
//=========================================
//=========================================

//=========================================
void set_halt_outputs()
//=========================================
{
    digitalWrite(fireSolenoid, LOW);
}

//=========================================
void set_idle_outputs()
//=========================================
{
    // Prevent the motors from moving by setting their targets to their current positions.
    digitalWrite(fireSolenoid, LOW);
}

//=========================================
void set_armed_outputs()
//=========================================
{
    // Prevent the motors from moving by setting their targets to their current positions.
    digitalWrite(fireSolenoid, LOW);
}

//=========================================
void set_aiming_outputs()
//=========================================
{
    // TODO: In Serial, set movementCompleted to false
   
    // Move to the vertical target position first.
    if ( !yMovementCompleted )
    {
        verticalLinac.moveTo(verticalLinacTarget);
        if( verticalLinac.isMovementComplete() )
        {
            movementRequested = false;
            yMovementCompleted = true;
            startMovementTime = 0;
        }
    }
    // Move to the horizontal target position when the vertical movement is done.
    else if ( !xMovementCompleted )
    {
        motor.moveTo(motorTarget);
        if( motor.isMovementComplete() )
        {
            movementRequested = false;
            xMovementCompleted = true;
            startMovementTime = 0;
        }
    }

    digitalWrite(fireSolenoid, LOW);
}


//=========================================
void set_drawing_outputs()
//=========================================
{
    if (!hasArrow)
    {
        drawingLinac.setMovementComplete(false);
        digitalWrite(fireSolenoid, HIGH);
        while(!drawingLinac.isMovementComplete())
        {
            drawingLinac.moveTo(zBowstringPosition);
        }
        delayWithInterrupts(1000);
        digitalWrite(fireSolenoid, LOW);
        delayWithInterrupts(1000);
        drawingLinac.setMovementComplete(false);
        hasArrow = true;
    }
    // TODO get drawn amount from EEPROM, use it.
    if (!zMovementCompleted)
    {
        drawingLinac.moveTo(zDrawnPosition);
        if ( drawingLinac.isMovementComplete() )
        {
            drawSerialIn = false;
            zMovementCompleted = true;
            startMovementTime = 0;
        }
    }
    
    digitalWrite(fireSolenoid, LOW);
}

//=========================================
void set_drawn_outputs()
//=========================================
{
    digitalWrite(fireSolenoid, LOW);
}

//=========================================
void set_retracting_outputs()
//=========================================
{
    // TODO get drawn amount from EEPROM, use it.
    if (!zMovementCompleted)
    {
        drawingLinac.moveTo(zRetractedPosition);
        if ( drawingLinac.isMovementComplete() )
        {
            retractSerialIn = false;
            zMovementCompleted = true;
            startMovementTime = 0;
        }
    }
    digitalWrite(fireSolenoid, LOW);
}

//=========================================
void set_firing_outputs()
//=========================================
{
    digitalWrite(fireSolenoid, HIGH);
}

//=========================================
void set_fired_outputs()
//=========================================
{
    digitalWrite(fireSolenoid, LOW);
}

//=========================================
//=========================================
// Transition Tests
//=========================================
//=========================================

//=========================================
void test_halt_transitions()
//=========================================
{
    // Never transition from halt.
}

//=========================================
void test_idle_transitions()
//=========================================
{
    if (movementRequested)
    {
        delayWithInterrupts(1000);
        currentState = STATE_AIMING;
    }
    else if ( digitalRead(fOptic) == LOW ) // digitalRead(armingChain) == HIGH )
    {
        currentState = STATE_ARMED;
    }
}

//=========================================
void test_armed_transitions()
//=========================================
{
    
    if (movementRequested)
    {
        currentState = STATE_AIMING;
    }
    else if ( //armingChainSerialIn // digitalRead(armingChain) == HIGH 
         /*&&*/ drawSerialIn // && digitalRead(drawIn) == HIGH
         && digitalRead(fOptic) == LOW
         && digitalRead(rOptic) == HIGH )
    {
        currentState = STATE_DRAWING;
        startMovementTime = 0;
    }
    else if ( digitalRead(fOptic) == HIGH) // digitalRead(armingChain) == LOW )
    {
        currentState = STATE_IDLE;
    }
}

//=========================================
void test_aiming_transitions()
//=========================================
{
    // Done when movement stops.
    if ( xMovementCompleted && yMovementCompleted )
    {
        currentState = STATE_IDLE;
    }
}

//=========================================
void test_drawing_transitions()
//=========================================
{
    if( zMovementCompleted )
    {
        if ( digitalRead(fOptic) == LOW 
             && digitalRead(rOptic) == LOW )
        {
            currentState = STATE_DRAWN;
        }
        else
        {
            // The drawing linac reports being at the drawn position, 
            // but there is not an arrow present in the front and back.
            
            //eStopInterrupt();
        }
    }
    
}

//=========================================
void test_drawn_transitions()
//=========================================
{
    if( retractSerialIn /*digitalRead(retractInput) == HIGH*/ )
    {
        currentState = STATE_RETRACTING;
        retractSerialIn = false;
        drawingLinacTarget = zRetractedPosition;
    }
    else if ( digitalRead(fOptic) == LOW && digitalRead(rOptic) == LOW && fireSerialIn == HIGH)
    {
        currentState = STATE_FIRING; 
        fireSerialIn = false;
    }
    else
    {
        // The machine is in the drawn position, 
        // but an arrow isn't present in both the front and back.
        // eStopInterrupt();
    }
}

//=========================================
void test_retracting_transitions()
//=========================================
{
    if ( zMovementCompleted )
    {
        if (digitalRead(rOptic) == HIGH )
        {
            currentState = STATE_ARMED;
        }
        else 
        {
            // The drawing linac reports being at the retracted position, 
            // but there is something blocking the rear sensor.
            
            // eStopInterrupt();
        }
    }
}

//=========================================
void test_firing_transitions()
//=========================================
{
   
    if ( digitalRead(fOptic) == HIGH
         && digitalRead(rOptic) == HIGH )
    {
        currentState = STATE_FIRED;
        hasArrow = false;
    }
}

//=========================================
void test_fired_transitions()
//=========================================
{
    long startTime = millis();
    delayWithInterrupts(3000);
    
    //if ( fireDelay == -1 ) 
    //{
    //    fireDelay = millis();
    //}
    // Wait one second after firing to start retracting.
    //else if ((millis() - fireDelay) >= 5000)
    //{
        currentState = STATE_RETRACTING;
        zMovementCompleted = false;
        drawingLinac.setMovementComplete(false);
    //    fireDelay = -1;
    //}
}

//=========================================
void check_movement_time()
//=========================================
{
    if ( startMovementTime == 0 )
    {
        startMovementTime = millis();
    } 
    else if ( ( millis() - startMovementTime ) > 15000 )
    {
        eStopInterrupt();
    }
}

//=========================================
//=========================================
// Interrupt Handlers
//=========================================
//=========================================

//=========================================
void eStopInterrupt()
//=========================================
{
    // Nothing should ever interrupt an eStop
    //noInterrupts();
    // Serial.println("eSTOP");
    currentState = STATE_HALT;
    
    unsigned long currentTime = millis();
    unsigned long startWaitTime = millis();  
    do
    {
      currentTime = millis();
      // Manually disable the linacs and motor by pin.
      digitalWrite(verticalLinacEnable, MOTOR_DISABLED);
      digitalWrite(drawingLinacEnable, MOTOR_DISABLED);
      digitalWrite(motorEnablePin, MOTOR_DISABLED);
      digitalWrite(fireSolenoid, LOW);
    } while( ( currentTime - startWaitTime ) < 2000 );
    
    drawingLinac.setMovementComplete(false);
    while( !drawingLinac.isMovementComplete() )
    {
        drawingLinac.moveTo(zRetractedPosition);
    }
    
    while(true)
    {
        // Allow nothing to happen until hardware reset.
        noInterrupts();
    }
}

void checkEthernetInput()
{
    if(!hasConnected)
    {
        tcpClient = server.available();
        if(tcpClient)
        {
            Serial.println("Client connected.");
            hasConnected = true;
        }
    }
    
    if(tcpClient && hasConnected && tcpClient.available())
    {
        char c = tcpClient.read();
        // Serial.println(c);
        if(c=='e' || c=='E')
        {
            eStopInterrupt();
        }
        else if(c == '~')
        {
            parseEthernetBuffer();
            clearEthernetBuffer();
        }
        else if (c != '\n')
        {
            buf[bufferSize++] = c;
        }
    }
    if (!tcpClient.connected())
    {
        hasConnected=false;
    }
}

void parseEthernetBuffer()
{
  if (bufferSize > 0)
  {
      char first = (char) buf[0];
      switch(first)
      {
          case 'e':
          case 'E':
          {
              eStopInterrupt();
              break;
          }
          case 'a':
          case 'A':
          {
              //armingChainSerialIn = atoi(&buf[1]);
              break;
          }
          case 'c':
          case 'C':
          {
              motorTarget = 0;
              xMovementCompleted = false;
              motor.setMovementComplete(false);
              verticalLinacTarget = 1000;
              yMovementCompleted = false;
              verticalLinac.setMovementComplete(false);
              movementRequested = true;
              break;
          }
          case 'd':
          case 'D':
          {
              if ( currentState != STATE_ARMED )
              {
                  tcpClient.print("ERR~");
                  //Serial.println("Wrong state");
              }
              else if (digitalRead(fOptic) != LOW)
              {
                  tcpClient.print("ERR~");
                  // Serial.println("fOptic should be LOW");
              }
              else if (digitalRead(rOptic) != HIGH )
              {
                  tcpClient.print("ERR~");
                  // Serial.println("rOptic should be HIGH");
              }
              else
              {
                  zMovementCompleted = false;
                  drawingLinac.setMovementComplete(false);
                  drawSerialIn = true;
              }
              break;
          }
          case 'f':
          case 'F':
          {
              if (currentState == STATE_DRAWN //&& armingChainSerialIn 
                  && digitalRead(fOptic) == LOW && digitalRead(rOptic) == LOW)
              {
                  fireSerialIn = true;
              }
              else
              {
                  tcpClient.print("ERR~");
              }
              break;
          }
          case'g':
          case 'G':
          {
              String ret = String(currentState);
              ret += "_" + String(digitalRead(fOptic));
              ret += "_" + String(digitalRead(rOptic));
              ret += "_" + String(!(xMovementCompleted && yMovementCompleted && zMovementCompleted));
              ret += "_" + String(motor.getPosition());
              ret += "_" + String(verticalLinac.getPosition());
              tcpClient.print(ret);
              break;
          }
          case 'r':
          case 'R':
          {
              if (currentState == STATE_DRAWN ) //&& armingChainSerialIn)
              {
                  zMovementCompleted = false;
                  drawingLinac.setMovementComplete(false);
                  retractSerialIn = true;
              }
              else
              {
                  tcpClient.print("ERR~");
              }
              break;
          }
          case 'x':
          case 'X':
          {
              char* substr = &buf[1];
              int requestedTarget = atoi(substr);
              // Serial.println(requestedTarget);
              if ( requestedTarget > -4096 && requestedTarget < 4096 && (currentState == STATE_IDLE || currentState == STATE_ARMED || currentState == STATE_AIMING))
              {
                  motorTarget = requestedTarget;
                  movementRequested = true;
                  xMovementCompleted = false;
                  motor.setMovementComplete(false);
              }
              else
              {
                  //Serial.println("REQ: " + requestedTarget);
                  //Serial.println("STATE: " + stateNames[currentState-1]);
                  tcpClient.write("ERR~");
              }
              break;
          }
          case 'y':
          case 'Y':
          {
              char* substr = &buf[1];
              int requestedTarget = atoi(substr);
              if ( requestedTarget >= 0 && requestedTarget < 4096 && (currentState == STATE_IDLE || currentState == STATE_ARMED))
              {
                  verticalLinacTarget = requestedTarget;
                  movementRequested = true;
                  yMovementCompleted = false;
                  verticalLinac.setMovementComplete(false);
              }
              else
              {
                  tcpClient.write("ERR~");
              }
              break;
          }
          
          case 'z':
          case 'Z':
          {
              // Serial.println(drawingLinac.getPosition());
          }
          
          default:
          {
              // Unrecognized command
              // Serial.print("ERR~~~~~");
          }
      }
  }
}

void clearEthernetBuffer()
{
    for(int i = 0; i < bufferSize; i++)
    {
        buf[i] = 0;
    }
    bufferSize = 0;
}

void delayWithInterrupts(long time)
{
    long curTime = millis();
    while ( millis() - curTime < time );
}
