RITMechArch/MechArch/src/arduino/Frameside/GearMotor/GearMotor.cpp

#include "GearMotor.h"
#include "RotaryEncoderReader.h"
 
GearMotor::GearMotor() {}

void GearMotor::init(int dirPin, int enablePin, int pinA, int pinB)
{
    _dirPin = dirPin;
    _enablePin = enablePin;
    reader = RotaryEncoderReader(pinA, pinB);

    digitalWrite(_dirPin, LOW);
    direction = false;
    analogWrite(_enablePin, 255);
    isEnabled = false;
    position = reader.getPosition();
}

void GearMotor::moveTo( int target )
{
    if (abs(target) > minMax) {
        // TODO: Report back an error
        return;
    }

    position = reader.getPosition();
    if(target > position && abs(target - position) > error) 
    {
        if(direction)
        {
            digitalWrite(_dirPin, LOW);
            direction = false;
        }
        analogWrite(_enablePin, power);
        isEnabled = true;
    }
    else if (target < position && abs(target - position ) > error) 
    {
        if(!direction)
        {
            digitalWrite(_dirPin, HIGH);
            direction = true;
        }
        analogWrite(_enablePin, power);
        isEnabled = true;
    }
    else
    {
        analogWrite(_enablePin, 0);
        isEnabled = false;   
    }

    if (isEnabled && abs(target - position) <= backlash)
    {
        movementComplete = true;
    }
    if (isEnabled && abs(target - position) <= propDist) 
    {
        power = calculatePower(abs(target - position) * 255 / propDist);
    } 
    else if (isEnabled && abs(target - position) > propDist) 
    {
       power = calculatePower(255);
    }
}

long GearMotor::getPosition()
{
    return position;
}

int GearMotor::calculatePower(int duty) 
{
    int ret = 0;
    if(duty > 0 && duty <= 255) 
    {
        ret = (duty * (maxPower - minPower)/255 + minPower);
    } 
    return ret;
}

void GearMotor::doPinA()
{
    reader.doEncoderA();
}

void GearMotor::doPinB()
{
    reader.doEncoderB();
}

bool GearMotor::isMovementComplete()
{
    return movementComplete;
}

void GearMotor::setMovementComplete(bool tf)
{
    movementComplete = tf;
}
