RITMechArch/MechArch/(commit log)

2012-10-21 Modified state transition code to include fBump/rBump interrupts. Converted const ints to #defines.
2012-10-28 Fixed bump interrupt race condition
2012-12-02 fixed analog pin numbers
    [arduino.ino]
2013-01-27 Added error reporting code
    [arduino.ino]
2013-02-03 Fixed HighMin/LowMax variable in LCD output code.
    [arduino.ino]
2013-02-03 fixed misplaced paren causing arrow read failure
    [MA_Pinout.xls]
2013-02-03 removed arrow checks in transitions where they caused issues
    [arduino.ino]
2013-06-02 First version of control box wiring test code.
2013-06-22 Addition of pcb design folder. Start of H-Bridge design.
2013-06-22 Added pcbs folder. For real, this time.
    [HBridge.sch]
2013-06-22 Added Gerber folder. For real.
2013-06-24 Begun design of H-Bridge controller.
    [HBridge.sch]
2013-06-24 Added ICs and begun wiring.
    [HBridge.sch]
2013-06-24 Added indication resistors.
    [HBridge.sch]
2013-06-24 Added indicators and current limiters.
    [HBridge.sch]
2013-06-24 Finished wiring. Inserted bypass caps.
    [HBridge.sch]
2013-06-25 Added bill of materials. Updated schematic with R and C values.
    [BoM.xls, HBridge.sch]
2013-06-25 Minor documentation updates.
    [HBridge.sch]
2013-06-30 Attached all stock footprints to symbols.
    [HBridge.sch]
2013-06-30 Updated bill of materials.
    [BoM.xls]
2013-07-01 Added custom footprints.
    [HBridge.sch]
2013-07-01 Updated BoM and fixed symbol-footprint mapping.
    [BoM.xls, HBridge.sch]
2013-07-01 Generated pcb layout files and netlists.
    [HBridge.new.pcb, HBridge.pcb, HBridge.sch]
2013-07-01 Begun pcb layout positioning.
    [HBridge.pcb, HBridge.sch]
2013-07-01 Updated ATTiny positioning for layout.
    [HBridge.sch]
2013-07-01 Ported schematic changes to pcb.
    [HBridge.new.pcb, HBridge.pcb]
2013-07-01 Completed first round of position optimization.
    [BoM.xls, HBridge.pcb, HBridge.sch]
2013-07-01 Optimized layout for routing. Added drill hits.
    [HBridge.pcb, HBridge.sch]
2013-07-01 Layout completed. First DRC check passed. Ready to begin routing.
    [HBridge.pcb]
2013-07-04 Routed pcb and connected ground plane.
    [HBridge.pcb]
2013-07-04 Shifted GND layer to component layer.
    [HBridge.pcb]
2013-07-04 Generated pcb fabrication files.
    [HBridge.GBL, HBridge.GBS, HBridge.GKO, HBridge.GTL, HBridge.GTO, HBridge.GTS, HBridge.XLN, HBridge.fab.gbr]
2013-07-04 Updated BoM with reference designators.
    [BoM.xls]
2013-07-16 Added silkscreen polarity markings on terminal blocks.
    [HBridge.pcb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]
2013-09-01 Added all documents from Google Drive
    [Archery Material.xlsx, Control_BOM.xlsx, Frame Design.dwg, MA_Pinout.xlsx]
2013-09-01 Fixed race condition in set_drawing_outputs()
    [arduino.ino]
2013-09-01 Updated Arduino Sync requirement
2013-09-08 Added ATTiny pinout.
    [ATTiny13A_Pinout.xls]
2013-09-08 Updated digital pins for new sensor configuration
    [MA_Pinout.xls]
2013-09-08 Updated code to reflect new digital sensor config
2013-09-22 Updated Pin Input values for fOptic and rOptic
    Optic sensors have been converted to digital inputs. New pins have been
    assigned to accommodate the change.
    [MA_Pinout.xls, MA_Pinout.xlsx]
2013-09-29 Adding VS project with prototype
2013-10-01 Split power delivery and control circuitry. Separated grounds.
    [HBridge.sch]
2013-10-05 Added local symbol/footprint caches and tied them to project files.
2013-10-05 Added BoM for testing H-Bridge switching modes.
    [SwitchingTestBoM.xls]
2013-10-05 Initial switching mode test code written.
2013-10-05 Updated signal side barrier blocks.
    [BoM.xls, HBridge.sch, SwitchingTestBoM.xls]
2013-10-06 Restructured PCB design directory.
    [HBridge.GBL, HBridge.GBS, HBridge.GKO, HBridge.GTL, HBridge.GTO, HBridge.GTS, HBridge.XLN, HBridge.fab.gbr]
2013-10-06 Tuned HBridge controller schematic. Begun layout of controller PCB.
    [HBridge.GBL, HBridge.GBS, HBridge.GKO, HBridge.GTL, HBridge.GTO, HBridge.GTS, HBridge.XLN, HBridge.fab.gbr]
2013-10-06 Updated pcb layout.
    [HBridge.pcb]
2013-10-06 Updated CBTester to avoid a strcat bug that caused erronous LCD display
    [CBTester.ino]
2013-10-08 Adjusted LED positions.
    [BoM.xls, HBridge.pcb]
2013-10-09 Changed over to 4 FET H-Bridge implementation. Added polygonal power routing.
    [HBridge.pcb, HBridge.sch]
2013-10-09 Finished FET gate trace and indication LED layout.
    [HBridge.pcb, HBridge.sch]
2013-10-09 Optimized gate trace layout.
    [HBridge.pcb, HBridge.sch, SwitchingTestBoM.xls]
2013-10-09 Updated footprint cache.
2013-10-10 Completed schematic layout for VO3120 opto-couplers.
    [HBridge.pcb, HBridge.sch]
2013-10-10 Begun laying out opto-couplers and control ICs.
    [HBridge.pcb, HBridge.sch]
2013-10-12 Completed general layout and trace placement.
    [HBridge.pcb, HBridge.sch]
2013-10-13 Updated bill of materials for HBridge and replacement parts.
    [BoM.xls, SwitchingTestBoM.xls]
2013-10-13 Inserted power ground plane.
    [HBridge.pcb]
2013-10-13 Added frame CAD files.
2013-10-13 Completed HBridge side ground plane.
    [HBridge.pcb]
2013-10-13 Completed control signal side ground plane.
    [HBridge.pcb]
2013-10-14 Fixed pin hole sizes. Added silkscreen markings for terminal blocks.
    [BoM.xls, HBridge.pcb]
2013-10-14 Removed heatsink placeholders. Signed PCB.
    [HBridge.pcb]
2013-10-14 Generated Gerber files. Cost updates to bill of materials.
    [BoM.xls, HBridge.pcb]
2013-10-14 Updated ATTiny13 pinout and pseudocode.
    [ATTiny13A_Pinout.xls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]
2013-10-16 Fixed silkscreen typo. Added input marks for positional control.
    [HBridge.pcb, HBridge.sch]
2013-10-16 Added filter cap for ADC-based position commands.
    [HBridge.pcb, HBridge.sch]
2013-10-17 Added design files for solenoid controller.
    [HBridge.GBL, HBridge.GBS, HBridge.GKO, HBridge.GTL, HBridge.GTO, HBridge.GTS, HBridge.XLN, HBridge.fab.gbr]
2013-10-17 Updated gate driver LED limiting resistor values.
    [BoM.xls, HBridge.sch]
2013-10-18 Updated control connection markings on PCB.
    [HBridge.pcb]
2013-10-20 Uploading the final mechanical drawings.
    [Fully Assembled Model.stl]
2013-10-27 Created solenoid schematic. Added all nets. Added all footprints, except diodes.
    [solenoid.sch]
2013-10-28 Updated BoM order quantities.
    [BoM.xls]
2013-11-01 Updated solenoid schematic with bypass caps and correct diode symbols. Added solenoid BoM.
    [HBridge.sch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]
2013-11-02 Completed solenoid PCB layout. Need to adjust component hole sizes.
    [HBridge.new.pcb, Solenoid_BoM.xls, solenoid.new.pcb, solenoid.sch]
2013-11-03 Adjusted outline for HBridge.
    [HBridge.pcb]
2013-11-03 Adjusted terminal block label on solenoid controller.
    [solenoid.pcb]
2013-11-10 Renamed letDownIn to resetIn to match documentation
    [CBTester.ino]
2013-11-10 Writing switching test code for HBridge.
2013-11-10 Initial work on PWM
2013-11-16 Split ATTiny source into PWM and Hard Logic Switching (HLS) versions.
    [HBridge.GBL, HBridge.GBS, HBridge.GKO, HBridge.GTL, HBridge.GTO, HBridge.GTS, HBridge.fab.gbr]
2013-11-16 Added budget tracking worksheet.
    [MechArchBudget.xls, SwitchingTestBoM.xls]
2013-11-29 Generated symbols, schematics, and layout needed for transmit side of occlusion sensors.
    [IR_Tx.new.pcb, IR_Tx.pcb, IR_Tx.sch, IR_Tx_BoM.xls]
2013-11-29 Added activity indicator LED for IR_Tx. Added outline and screw holes for IR_Tx PCB.
    [IR_Tx.new.pcb, IR_Tx.pcb, IR_Tx.sch, IR_Tx_BoM.xls]
2013-11-30 Completed IR_Rx schematic. May replace photodiode with phototransistor and change limiter resistor.
    [IR_Tx_BoM.xls]
2013-11-30 Completed IR_Rx schematic.
    [IR_Rx.sch]
2013-11-30 Completed IR_Rx PCB layout. Added silk labels to both Tx and Rx sides.
    [IR_Rx.sch, IR_Rx_BoM.xls, IR_Tx.pcb]
2013-11-30 Updated budget info.
    [MechArchBudget.xls]
2013-11-30 Added BoM for bump switches.
    [bumpSwitch_BoM.xls]
2013-12-03 Fixed hole size on HBridge buffer footprint. Checkoffs for component placement.
    [BoM.xls, HBridge.pcb]
2013-12-04 Added IR_Rx PCB design files.
    [IR_Rx.pcb]
2013-12-04 Updated resistor footprints.
    [HBridge.new.pcb, HBridge.pcb, HBridge.sch, IR_Rx.pcb, IR_Rx.sch, IR_Tx.new.pcb, IR_Tx.pcb, IR_Tx.sch]
2013-12-05 Standardized all boards to +12V(S).
    [IR_Rx.pcb, IR_Rx.sch]
2013-12-05 Fixed footprint hole sizes.
    [HBridge.pcb, IR_Rx.pcb, IR_Tx.pcb, IR_Tx.sch, IR_Tx_BoM.xls, solenoid.pcb]
2013-12-15 Added instructions for burning ATTiny reset fuse
2014-02-14 Uploading boost converter schematic and BOM
    [Boost Converter BOM.xlsx, Boost Converter.sch, ~Boost Converter.sch]
2014-02-16 Uploaded the boost converter power side PCB.
    Work in progress file. Control electronics still to be added to the
    layout.
    [Boost Converter.pcb]
2014-02-16 Uploaded boost converter PCB.
    Part labeling still needs to be completed.
    [Boost Converter.pcb]
2014-02-16 Added board outline to boost converter PCB
    [Boost Converter.pcb]
2014-02-16 Uploaded image of the boost converter PCB
2014-02-16 Updated code with new motor control process. Updated pinout documents to reflect changes.
    [MA_Pinout.xls, MA_Pinout.xlsx]
2014-02-16 Uploaded gerber files of the boost converter.
    [Boost Converter - Board Outline.gbr, Boost Converter - Bottom Copper (Resist).gbr, Boost Converter - Bottom Copper.gbr, Boost Converter - Drill Data - Through Hole (Unplated).drl, Boost Converter - Drill Data - Through Hole.drl, Boost Converter - Drill Ident Drawing - Through Hole.gbr, Boost Converter - Top Copper (Resist).gbr, Boost Converter - Top Copper.gbr]
2014-02-19 Added a purchase list as of 2/19/2014
    Does not include cost of PCBs.
    [Things to buy as of 2-19-2014.xlsx]
2014-02-19 Updated the boost converter PCB and buy list.
    PCB updated to include Reference designators and hole sizes have been
    fitted properly to the components. Buy list was updated so that parts
    with the same number are not listed twice.
    [Boost Converter.pcb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]
2014-02-23 Finalized the boost converter PCB and buy list.
    [Boost Converter - Bottom Copper (Resist).gbr, Boost Converter - Bottom Copper.gbr, Boost Converter - Drill Data - Through Hole (Unplated).drl, Boost Converter - Drill Data - Through Hole.drl, Boost Converter - Drill Ident Drawing - Through Hole.gbr, Boost Converter - Top Copper (Resist).gbr, Boost Converter - Top Copper.gbr, Boost Converter - Top Silkscreen.gbr]
2014-02-23 Updated parts list and boost converter PCB
    [Boost Converter.pcb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]
2014-02-23 Added wire.
    [MechArchBudget.xls, Things to buy as of 2-19-2014.xlsx]
2014-02-23 Fixed through hole soldermask.
    [solenoid.pcb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]
2014-03-16 Fixed solenoid controller to run on 48V.
    [solenoid.new.pcb, solenoid.pcb, solenoid.sch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]
2014-03-16 Fixed solenoid controller.
2014-03-16 Fixed the Fired output so the machine actually retracts after firing.
    [arduino.ino]
2014-03-16 Added timer code to shut the system down if stuck in a moving state for more than eleven seconds.
    [arduino.ino]
2014-04-08 Changed digitalWrite ordering, removed bump checks
    Electrical constraint: The motor must be disabled if the direction
    changes. The ordering of digitalWrite calls was changed so the motor is
    never enabled when direction is set.
    SetDrawingOutputs and setRetractingOutputs only set the motor's inputs
    if the relevant bump switch was on. This prevented the machine from
    moving mid draw/retract. These checks were removed.
    [arduino.ino]
2014-04-13 Fixed compilation error in Arduino code.
    [arduino.ino]
2014-04-13 Updated state diagram to use current inputs
2014-04-13 Fixed the ordering of motor commands in the e-stop interrupt
    [arduino.ino]
2014-04-27 Updated optic sensor reading
    The occlusion sensor will now send HIGH if an arrow is present and LOW
    if an arrow is not. This change inverted all optic sensor reads to
    accommodate.
    [arduino.ino]
2014-04-27 Fixed motor jitter after bumps are tripped
    When the motor stops moving because the front bump or rear bump was
    tripped, the motor would start again for one loop cycle until the state
    changed. This fix added a conditional the prevent the extra movement.
    [arduino.ino]
2014-05-01 Commented out all optic sensor reads
2014-05-16 Disabled interrupts and fixed timing conditional in eStop
    [arduino.ino]
2014-06-10 Changed folder setup for arduino sketch
2014-06-10 Updated linac servo code with proportional control
2014-06-10 Commented updated linac servo code
2014-09-07 Added preliminary buy list for R2.
    [Mech Arch R2 Buy List.xlsx]
2014-09-14 Added 4 channel optoisolators to R2 buy list.
    [Mech Arch R2 Buy List.xlsx]
2014-10-02 Changed positional feedback sampling to use median-averaging to correct for noise.
    [Servo_Linac.ino]
2014-10-12 Added rotary encoder reader Arduino sketch.
2014-10-22 Updated R2 buy list
    [Mech Arch R2 Buy List.xlsx]
2014-11-02 Updated buy list and added motor mount design
    [Gear_Motor_Mount.scad, Mech Arch R2 Buy List.xlsx]
2014-11-02 Added Initial Pinout for R2
    [Pinout-R2.xlsx]
2014-11-09 Revert "Added rotary encoder reader Arduino sketch."
    This reverts commit aa8c1c4a16179b6f367adc328fcbfc60aef969c1.
2014-11-09 Revert "Revert "Added rotary encoder reader Arduino sketch.""
    This reverts commit 26a07af4173137e1c313f7ffb162fa6ced323f8e.
2014-11-09 Arduiono Telnet Server
    code to run a telnet server on the Arduino
2014-11-09 Updated R2 Pinout with control box code and descriptions.
    [Pinout-R2.xlsx]
2014-11-09 Added updated R2 buy list.
    [Mech Arch R2 Buy List.xlsx]
2014-11-09 Added methods for UI buttons to C# code
2014-11-18 Added initial EEPROM byte listing.
    EEPROM values to be stored on the frameside Arduino. Values are spaced
    four bytes apart to accommodate future changes with minimal modification
    required.
    [EEPROM Byte Listing.xlsx]
2014-11-23 Added an ADC communication test program
2014-11-24 Added ADC Reset Pin to Pinout
    Reset pin for the analog to digital converter
    [Pinout-R2.xlsx]
2015-01-28 Motor Dynamics Code
    Started an arduino sketch in order to test the physical dynamics of the
    motors.
    [EEPROM Byte Listing.xlsx]
2015-02-22 Updated code to characterize the motor behavior
2015-03-01 code clean up
    Removed all referances to bump sensors and changed defines to const int
2015-03-08 Updated motor dynamics code to stop the linac.
2015-03-15 Initial LinearActuator class code
    This version of the LinearActuator class uses the older median filtering
    algorithm to determine position from analog input.
    This version of the code has not yet been physically tested.
2015-04-06 Updated Linear Actuator class to use exponential filter
    Tested and working for vertical linac.
2015-04-12 Added gear motor controller class.
2015-04-12 Added Tester sketches for linac, motor, and both.
    Moved Tester sketches into separate sub-folder.
2015-04-19 Added initial network protocol
    [NetworkProtocol.xlsx]
2015-04-19 Power calculation changes
2015-04-19 Added tester for two linacs and a gear motor
2015-04-19 Added comunication in other direction
    [NetworkProtocol.xlsx]
2015-04-19 Removed ADC pins from R2 Pinout
    [Pinout-R2.xlsx]
2015-04-19 Added initial frameside sketch.
    This is the sketch that the frameside Arduino will run. Implementation
    of serial communication with the control box has not yet been
    implemented, nor has reading of hardcoded EEPROM values.
2015-04-19 Updated pinout and sketch to free serial pin
    The serial pins TX0 and RX0 are on Arduino pin 1 and 0 respectively, so
    they can not be used by other components.
    [Pinout-R2.xlsx]
2015-04-23 Updated Frameside Arduino with new movement logic.
    To be tested independently before implementing serial communications
    with the control box Arduino.
2015-04-23 Added rotary encoder pins to pinout and sketch.
    The R2 Pinout diagram and frameside sketch did not include pins for the
    rotary encoder, which gives horizontal position data. Both have been
    updated.
    [Pinout-R2.xlsx]
2015-04-26 State Machine
    boolean and switch for determining which states we can switch to
    depending on our current state.
2015-04-27 Added Initial Working State Machine sketch
    Replaced old "FramesideComplete" sketch with new "Frameside" sketch,
    tested with two linacs and the gear motor in a bench test 4/27/15
    [Frameside.ino, LinearActuator.cpp, LinearActuator.h, ThreePartTester.ino]
2015-04-29 Initial commit of pixel detection and target setting.
    Network, camera components to be uploaded later today.
2015-04-30 Added initial ethernet communication to frameside arduino.
    [Pinout-R2.xlsx]
2015-04-30 Intermediate changes to frameside, C#, and tester classes
    May need further editing; pushed now for battery issues.
    [Pinout-R2.xlsx]
2015-05-01 Functional interaction between UI and state machine over ethernet
    Doesn't have all e-stop conditions fully implemented; needs
    initialization and extra drawing logic to grab the screen.
    [Frameside.ino]
2015-05-01 Updated functional UI -- Tested full frame
2015-05-01 Added functional camera feed to temp nikoncswrapper project
2015-05-02 Minor frameside and UI updates
2015-06-28 Initial upload of XBox 360 controller software
    Uploading source and EXE for a program that tests the basic
    functionality of a wrapper for an XBox 360 controller. Compiled on win7
    sp1 64 bit.
    [Gear_Motor_Mount.dxf, Gear_Motor_Mount.scad, Gear_Motor_Mount.stl, Gear_Motor_Mount_Holes.xlsx]
2015-06-29 Added arduino and host code for gamepad control
    Control software has no safety checks and no feedback of any sort. DO
    NOT USE WITH ARMED MACHINE. The program is meant for proof of concept
    testing of software fundamentals.
2015-06-29 Added input to select comport of arduino
2015-07-01 Updated backend of Mecharch_360
    Improved usability of c++ code for the mecharch_360 system. Updated
    arduino code to match.
2015-07-15 Added initial networking field information for Revision 2.5. Valid values may need adjustment.
    [NetworkingFields.ods]
2015-07-16 Removed some older files from the doc folder and updated project synopsis.
    [MA_Pinout.xls, MA_Pinout.xlsx]
2015-08-10 Removed Visual Studio junk from the file system
    Also made some small modifications to the backend in an attempt to use
    winsock for communicating between the computer and the arduino.
2015-08-15 Initial status, frame, and network client classes with class interaction.
2015-08-15 Added initial frameside sketch based on R2 sketch -- needs significant work before complete.
2015-10-13 Most recent working Frameside classes as of 11 Oct 2015.
2015-10-27 Added working Frameside server, minor cleanup
2015-11-19 Added schematic for the voltage controller
    [Voltage Controller.sch]
